reiserlab/LED-Display_G6_Hardware_Panel/panel_rp2354_20x20_four-color_v0p5/assets/panel_rp2354_20x20-v0.4.0-bottom.png

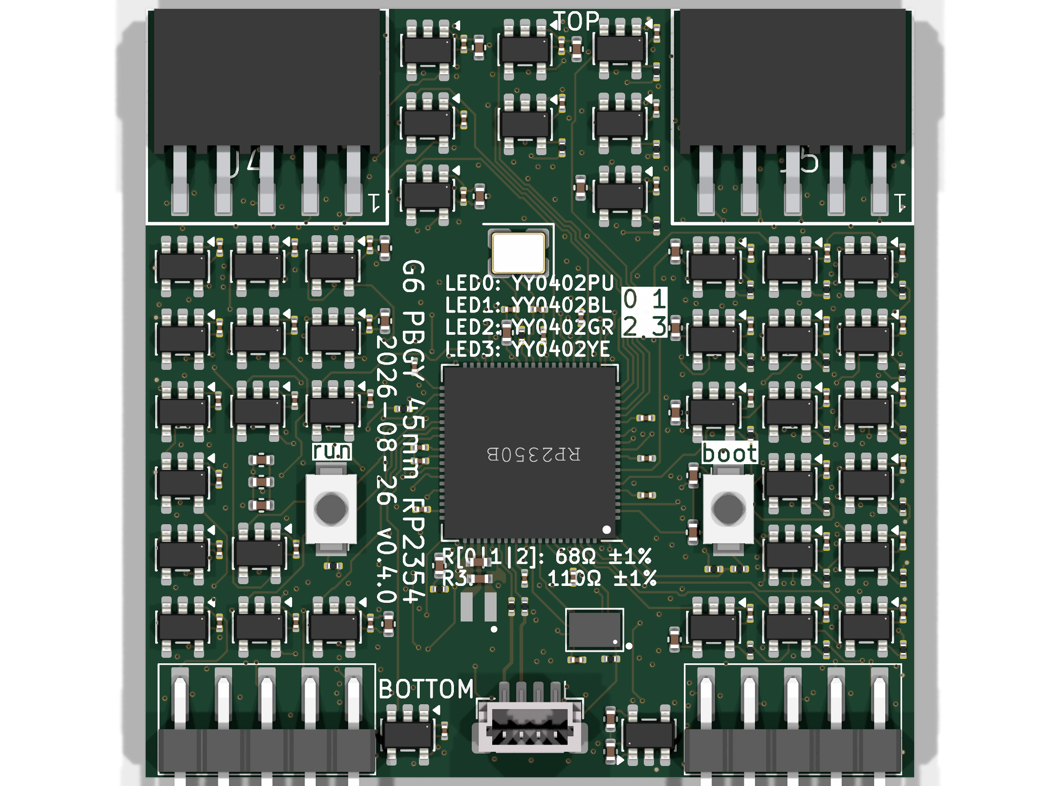
panel_rp2354_20x20_four-color_v0p5/assets/panel_rp2354_20x20-v0.4.0-bottom.png
