reiserlab/LED-Display_G6_Hardware_Panel/panel_rp2354_20x20_ir-red_v0p4/assets/panel_rp2354_20x20-v0.4.2-bottom-drivers-detail.png

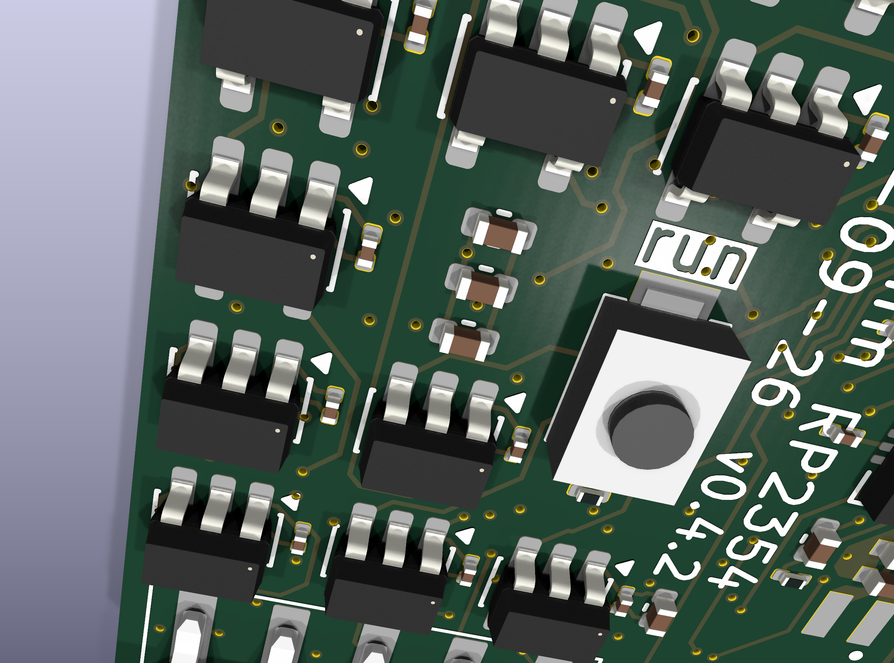
panel_rp2354_20x20_ir-red_v0p4/assets/panel_rp2354_20x20-v0.4.2-bottom-drivers-detail.png
