reiserlab/LED-Display_G6_Hardware_Panel/panel_rp2354_20x20_four-color_v0p5/production/v0p5r2/bom.csv

Designator | Footprint | Quantity | Value | LCSC Part #
C1, C2 | 0201 | 2 | 15pF | C541259
C10, C11, C12, C13, C14, C15, C16, C17, C18, C19, C20, C21, C22, C23, C24, C25, C26, C27, C28, C29, C3, C30, C31, C32, C33, C34, C35, C36, C37, C38, C39, C40, C41, C42, C43, C44, C45, C46, C47, C48, C49, C50, C51, C52, C53, C54, C55, C56, C57, C58, C6, C9 | 0201 | 52 | 100nF | C76939
C4, C5, C7, C8 | 0402 | 4 | 4.7uF | C368809
C59, C60, C61, C62, C63, C64, C65, C66, C67, C68, C69, C70, C71, C72, C73, C74, C75, C76 | 0402 | 18 | 10uF | C315248
D1, D10, D100, D11, D12, D13, D14, D15, D16, D161, D162, D163, D164, D165, D166, D167, D168, D169, D17, D170, D171, D172, D173, D174, D175, D176, D177, D178, D179, D18, D180, D19, D2, D20, D241, D242, D243, D244, D245, D246, D247, D248, D249, D250, D251, D252, D253, D254, D255, D256, D257, D258, D259, D260, D3, D321, D322, D323, D324, D325, D326, D327, D328, D329, D330, D331, D332, D333, D334, D335, D336, D337, D338, D339, D340, D4, D5, D6, D7, D8, D81, D82, D83, D84, D85, D86, D87, D88, D89, D9, D90, D91, D92, D93, D94, D95, D96, D97, D98, D99 | 0402 | 100 | LED_T0 | C43790508
D101, D102, D103, D104, D105, D106, D107, D108, D109, D110, D111, D112, D113, D114, D115, D116, D117, D118, D119, D120, D181, D182, D183, D184, D185, D186, D187, D188, D189, D190, D191, D192, D193, D194, D195, D196, D197, D198, D199, D200, D21, D22, D23, D24, D25, D26, D261, D262, D263, D264, D265, D266, D267, D268, D269, D27, D270, D271, D272, D273, D274, D275, D276, D277, D278, D279, D28, D280, D29, D30, D31, D32, D33, D34, D341, D342, D343, D344, D345, D346, D347, D348, D349, D35, D350, D351, D352, D353, D354, D355, D356, D357, D358, D359, D36, D360, D37, D38, D39, D40 | 0402 | 100 | LED_T1 | C44599418
D121, D122, D123, D124, D125, D126, D127, D128, D129, D130, D131, D132, D133, D134, D135, D136, D137, D138, D139, D140, D201, D202, D203, D204, D205, D206, D207, D208, D209, D210, D211, D212, D213, D214, D215, D216, D217, D218, D219, D220, D281, D282, D283, D284, D285, D286, D287, D288, D289, D290, D291, D292, D293, D294, D295, D296, D297, D298, D299, D300, D361, D362, D363, D364, D365, D366, D367, D368, D369, D370, D371, D372, D373, D374, D375, D376, D377, D378, D379, D380, D41, D42, D43, D44, D45, D46, D47, D48, D49, D50, D51, D52, D53, D54, D55, D56, D57, D58, D59, D60 | 0402 | 100 | LED_T2 | C9900325345
D141, D142, D143, D144, D145, D146, D147, D148, D149, D150, D151, D152, D153, D154, D155, D156, D157, D158, D159, D160, D221, D222, D223, D224, D225, D226, D227, D228, D229, D230, D231, D232, D233, D234, D235, D236, D237, D238, D239, D240, D301, D302, D303, D304, D305, D306, D307, D308, D309, D310, D311, D312, D313, D314, D315, D316, D317, D318, D319, D320, D381, D382, D383, D384, D385, D386, D387, D388, D389, D390, D391, D392, D393, D394, D395, D396, D397, D398, D399, D400, D61, D62, D63, D64, D65, D66, D67, D68, D69, D70, D71, D72, D73, D74, D75, D76, D77, D78, D79, D80 | 0402 | 100 | LED_T3 | C9900325346
J1 | JST_SH_BM04B-SRSS-TB_1x04-1MP_P1.00mm_Vertical | 1 | Conn_01x04 | C160390
J2, J3 | PinHeader_1x5_M20-8890545R | 2 | Conn_01x05 | C46061678
J4, J5 | ConnRcpt_1x5_SMH-105-02-X-S | 2 | Conn_01x05 | C5142238
J6 | JST_SH_BM03B-SRSS-TB_1x03-1MP_P1.00mm_Vertical | 1 | Conn_01x03 | C160389
L1 | L_pol_2016 | 1 | 3.3uH | C42411119
R1, R4 | 0201 | 2 | 10k | C473048
R10, R14, R18, R22, R26 | 0402 | 5 | R_T1 | C852891
R11, R15, R19, R23, R27 | 0402 | 5 | R_T2 | C852930
R12, R16, R20, R24, R28 | 0402 | 5 | R_T3 | C852485
R13, R17, R21, R25, R9 | 0402 | 5 | R_T0 | C852891
R2, R3, R5 | 0201 | 3 | 1k | C270365
R29, R6 | 0201 | 2 | 33 | C295794
R7, R8 | 0201 | 2 | 27 | C473051
SW1, SW2 | TS-1088-AR02016 | 2 | SW_Push | C720477
U1 | flashmem_PSON50P300X200X60-9N | 1 | APS6404L-3SQR | C3040877
U10, U11, U12, U13, U14, U15, U16, U17, U18, U19, U20, U21, U22, U23, U24, U25, U26, U27, U28, U29, U3, U30, U31, U32, U33, U34, U35, U36, U37, U38, U39, U4, U40, U41, U42, U5, U6, U7, U8, U9 | SOT-23-5 | 40 | UCC27517 | C99395
U2 | RP2350-QFN-80-1EP_10x10_P0.4mm_EP3.4x3.4mm_ThermalVias | 1 | RP2354B_80QFN | C39843328
U43 | SOT-23-5 | 1 | AP2112K-3.3 | C51118
Y1 | Crystal_SMD_3225-4Pin_3.2x2.5mm | 1 | ABM8-272-T3 | C20625731
