reiserlab/LED-Display_G6_Hardware_Panel/panel_rp2354_20x20_four-color_v0p5/assets/panel_rp2354_20x20-v0.4.0.step

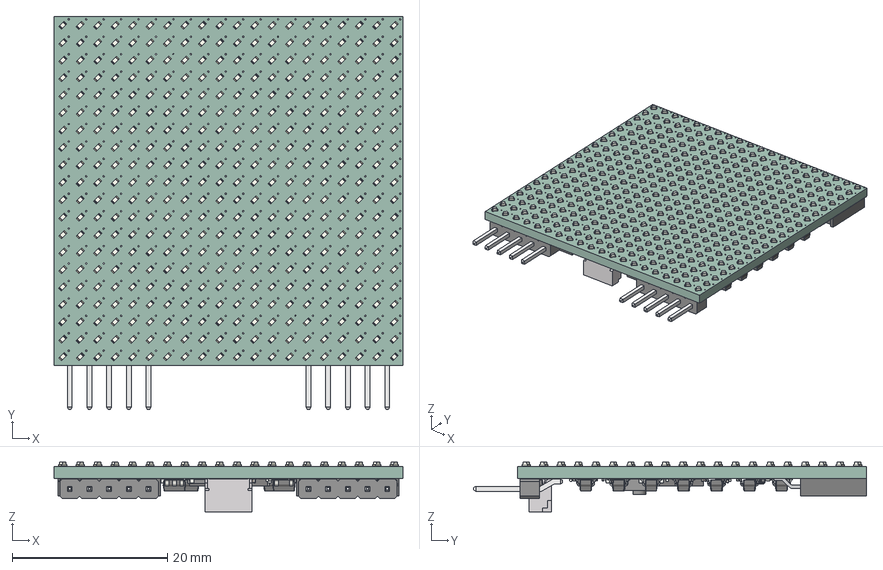
[picture p12: CAD file, 2026-10-18, an earlier design]
panel_rp2354_20x20_four-color_v0p5/assets/panel_rp2354_20x20-v0.4.0.step
45.0 x 50.7 x 6.43 mm
LED_0402_1005Metric x 400
C_0201_0603Metric x 54
C_0402_1005Metric x 22
SOT-23-5 x 41
R_0201_0603Metric x 29
BM04B-SRSS
Crystal_SMD_3225-4Pin_3.2x2.5mm
insulation_001 x 2
pin_001 x 2
pin_002 x 2
pin_003 x 2
pin_004 x 2
pin_005 x 2
ButtonPad x 2
rp2350text
panel_rp2354_20x20_silkscreen x 2
panel_rp2354_20x20_PCB
