reiserlab/LED-Display_G6_Hardware_Panel/(list of files, cad)

Other CAD files:
panel_rp2354_20x20_four-color_v0p5/assets/panel_rp2354_20x20-v0.5.0.step
