reiserlab/LED-Display_G6_Hardware_Panel/panel_rp2354_20x20_four-color_v0p5/assets/panel_rp2354_20x20-v0.5.0.pdf

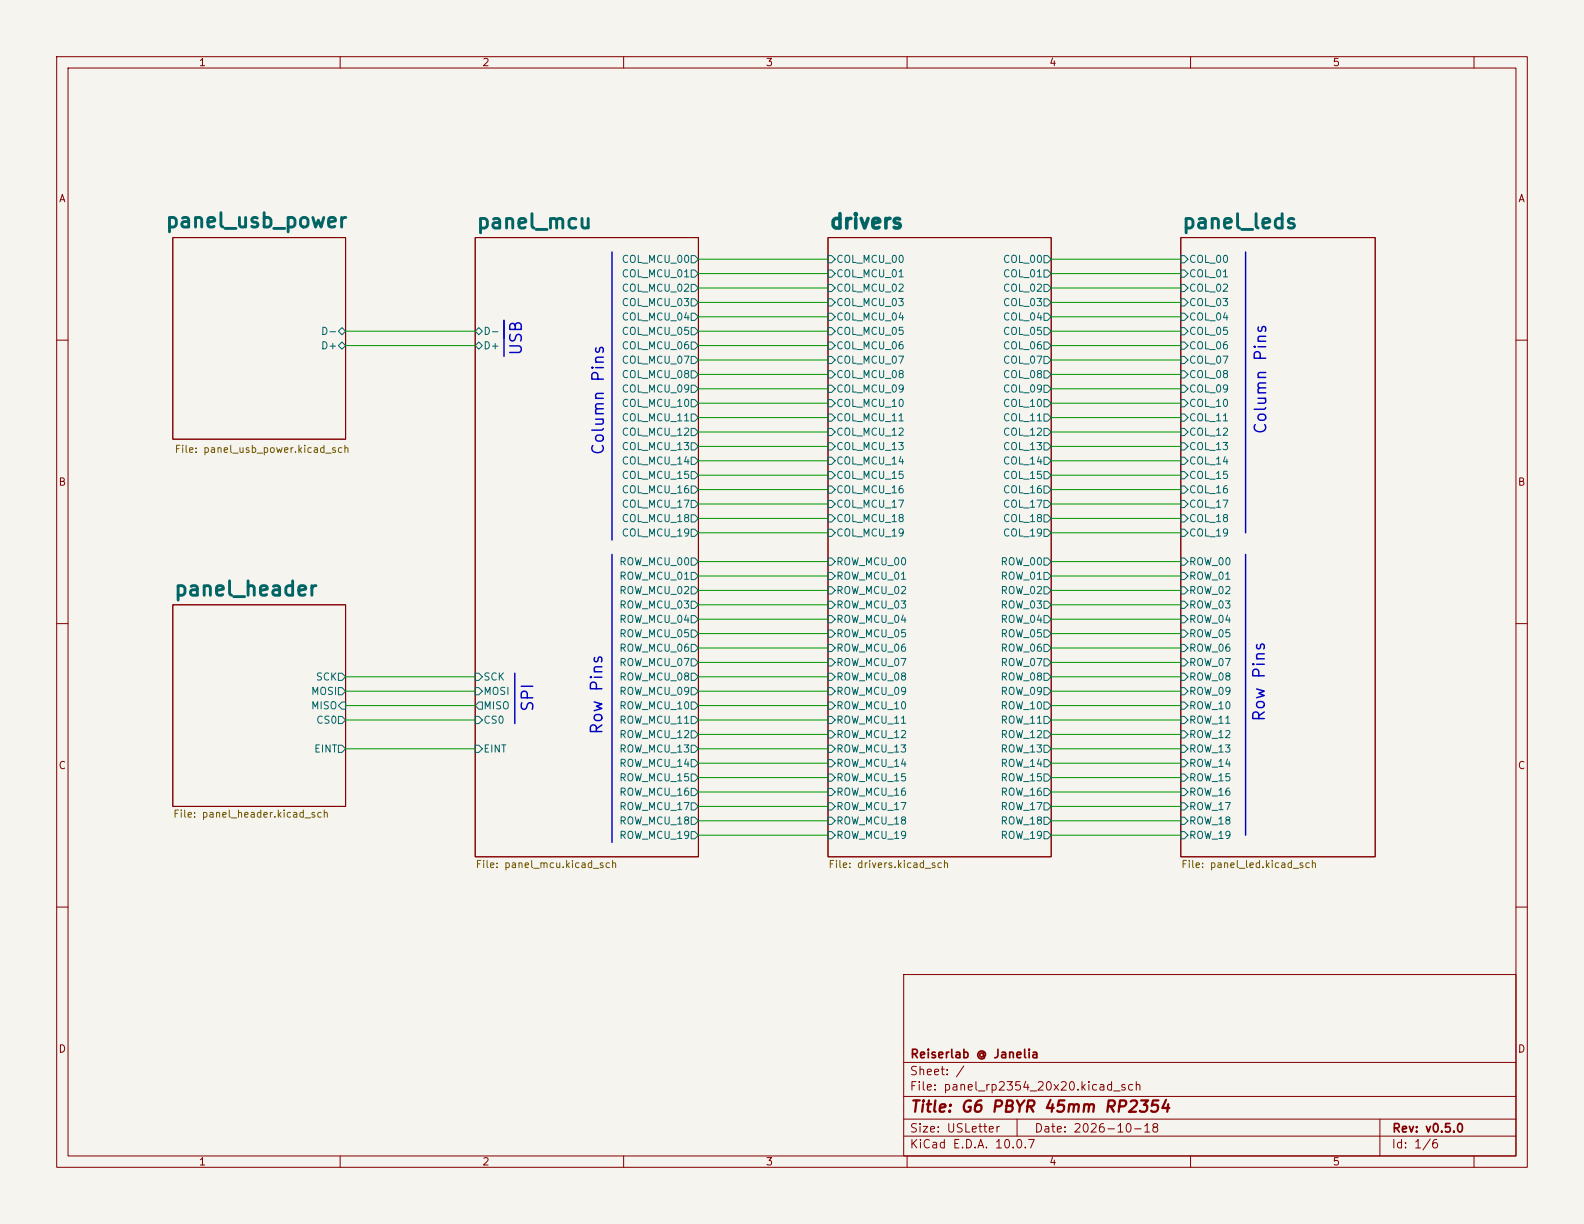
[picture p19: page 1]

Size: USLetter | Rev: v0.5.0
KiCad E.D.A. 10.0.7 | Id: 1/6

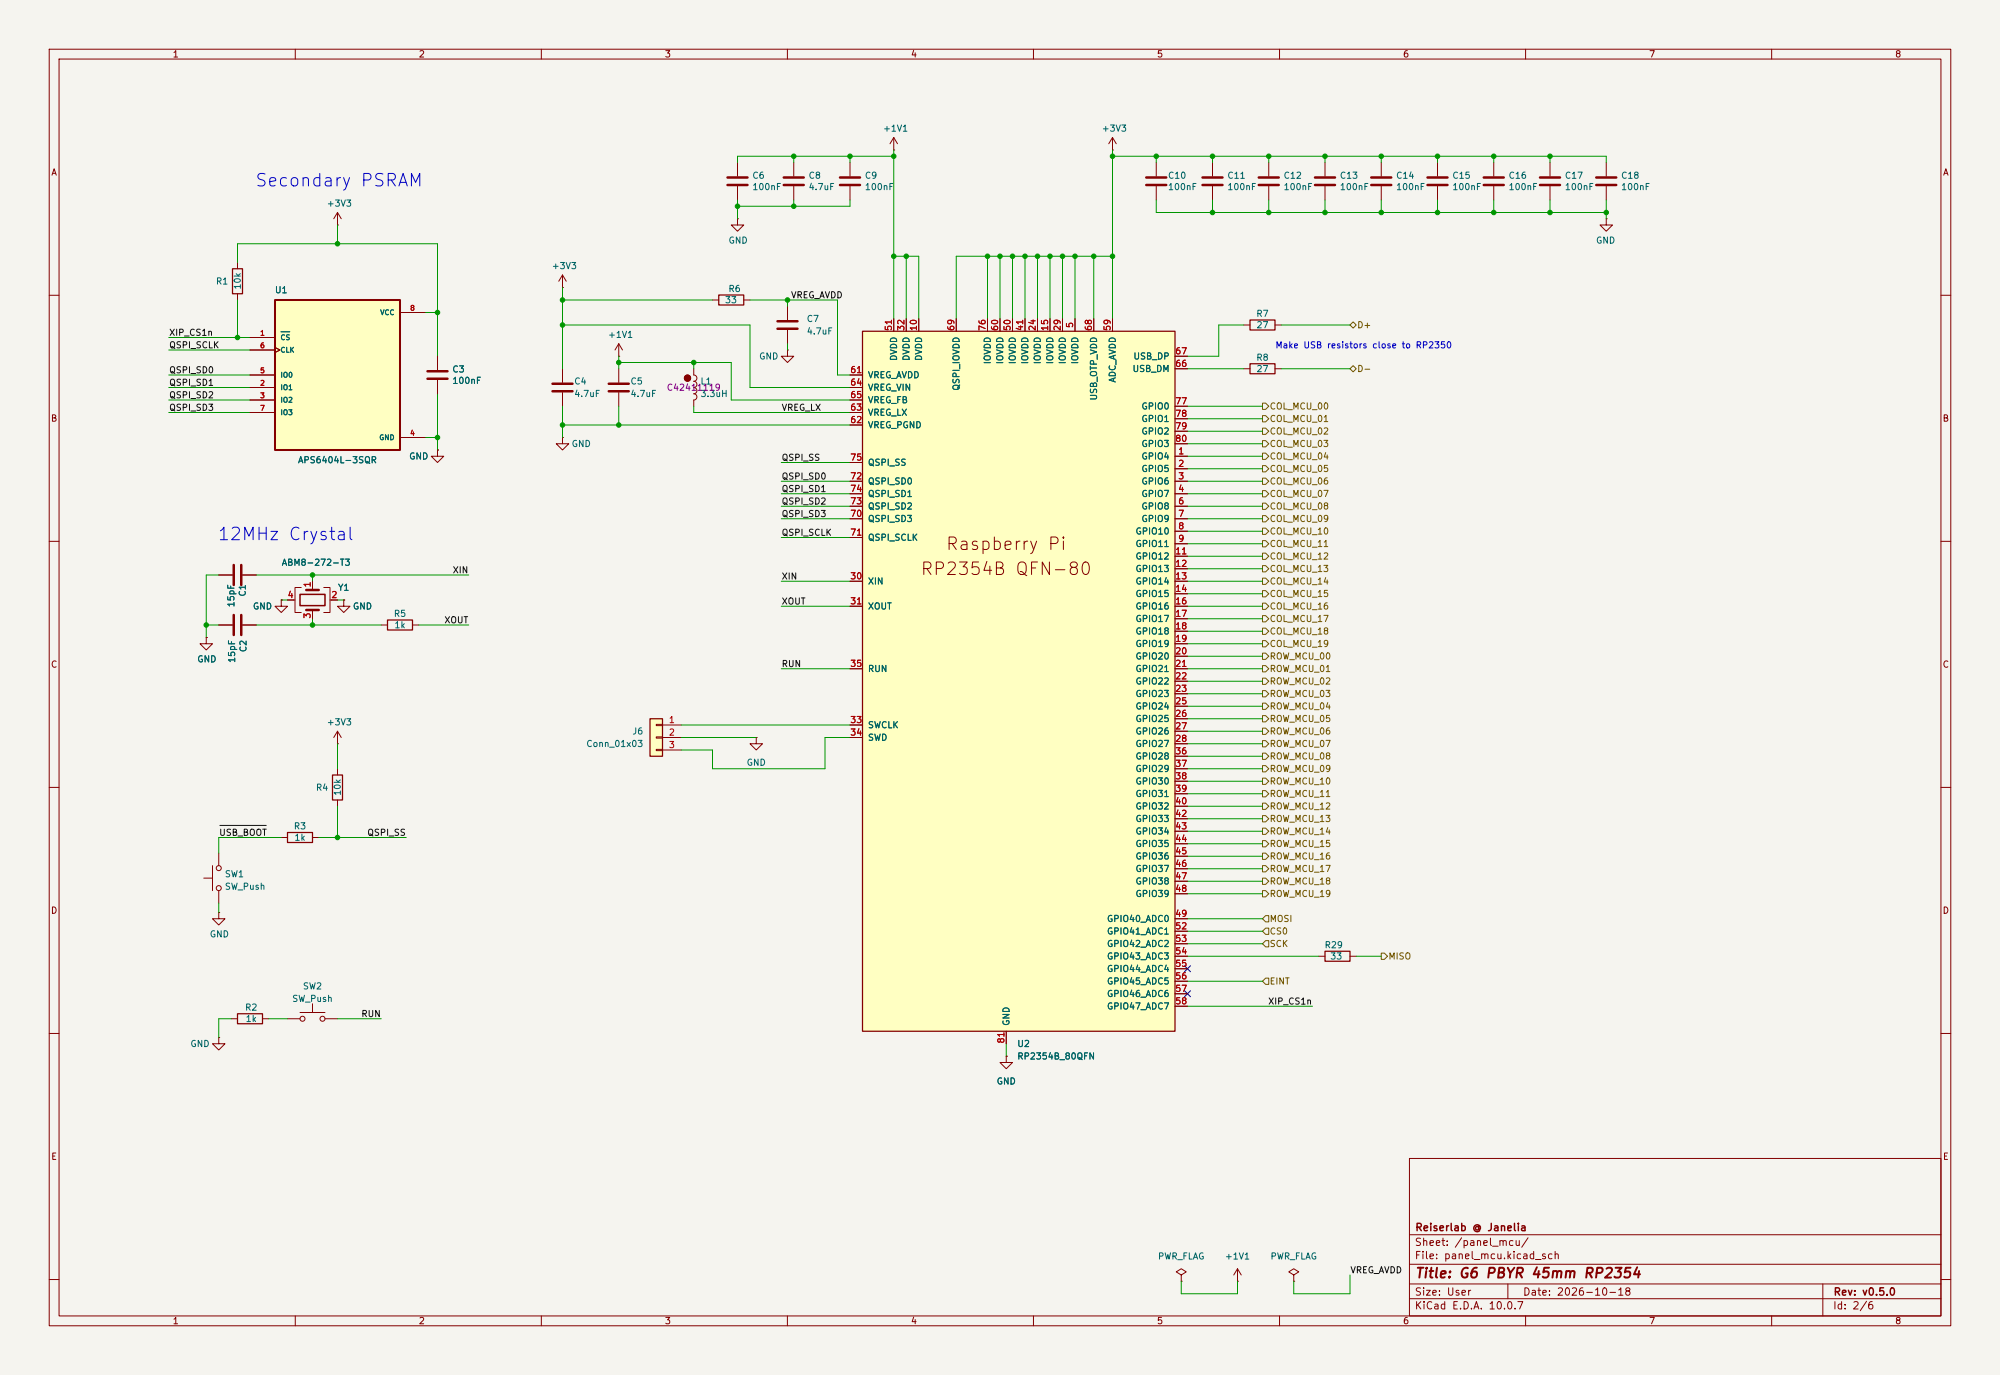
[picture p20: page 2]

5 GPIO8 6 GPIO9 7 GPIO10 8 GPIO11 9 DVDD 10 GPIO12 11 GPIO13 12 GPIO14 13 GPIO15 14 IOVDD 15 GPIO16 16 GPIO17 17 GPIO18 18 GPIO19 19 GPIO20 20 GPIO21 21 GPIO22 22 GPIO23 23 IOVDD 24 GPIO24 25 GPIO25 26 GPIO26 27 GPIO27 28 IOVDD 29

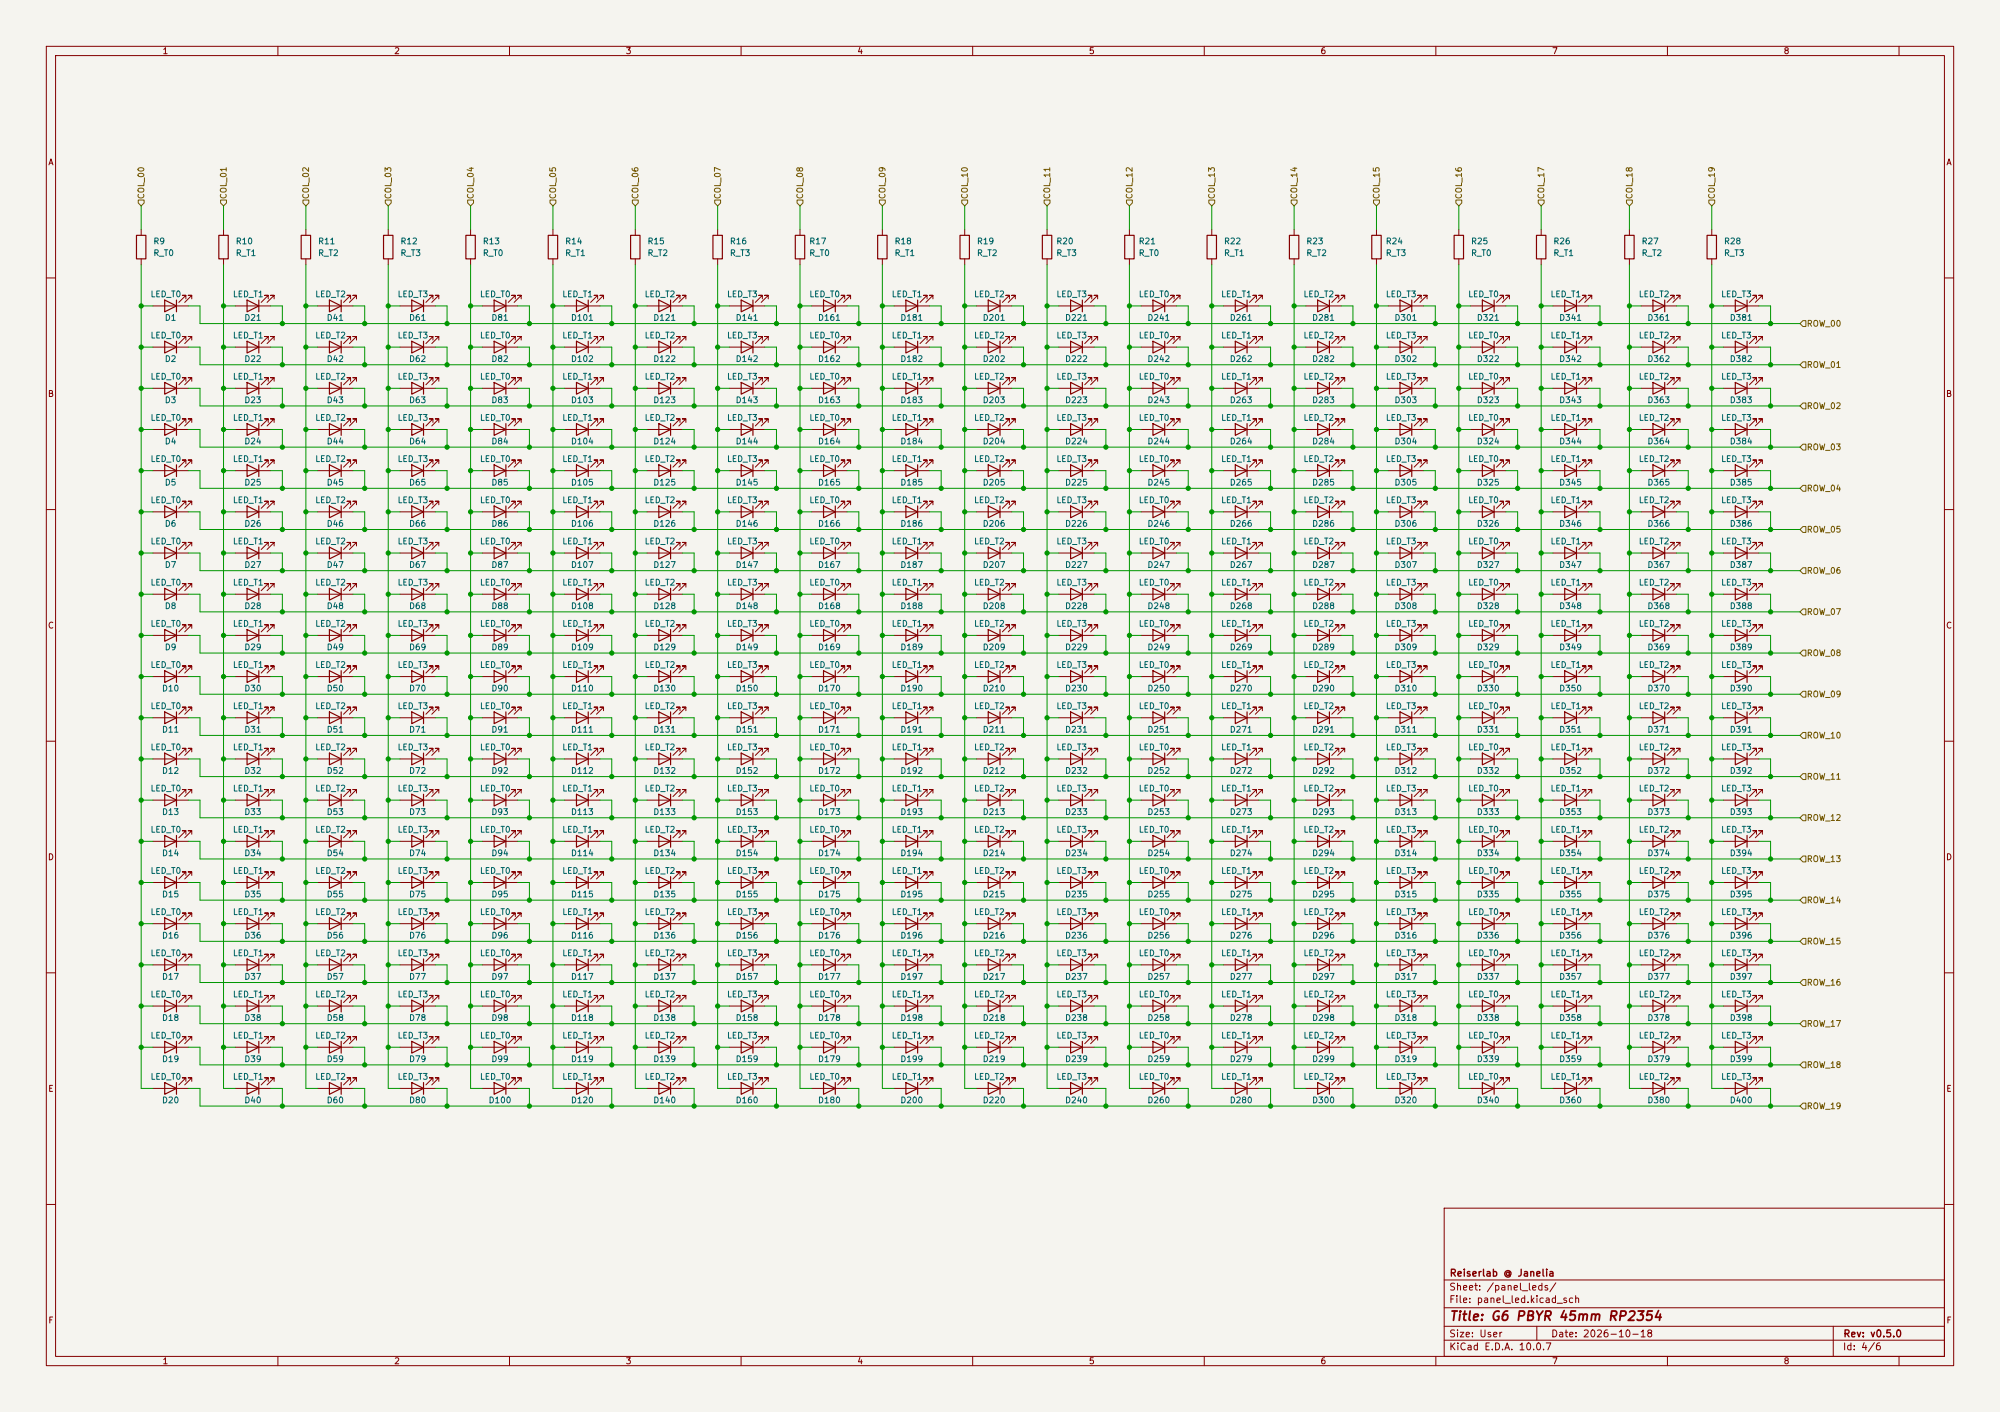
[picture p21: page 3]

LED_T0 D2 LED_T0 | | | LED_T3 | | R14 R_T1 | D122 LED_T2 | LED_T3 R15 R_T2 D64 D143 LED_T3 | | LED_T1 | LED_T2 D162 | | LED_T0 | D262 | LED_T2 D282

LED_T0 | | LED_T2 | LED_T3 | LED_T0 D83 | | | | | | D204 | LED_T3 D63 | | | | LED_T1 D270

LED_T2 | | LED_T0 | LED_T1 | | | | D186 D183 | LED_T2 D202 | D223 | LED_T0 D243 | LED_T1 D265 | | | LED_T0 D322 | LED_T1 | LED_T2 D323 D363

LED_T0 | LED_T1 | | | | | LED_T2 D124 | | | LED_T1 D188 | D203 | | | | | LED_T3 D305 LED_T3 | | LED_T1 D345 | LED_T2 D365
LED_T1 LED_T1 D28 | LED_T2 | D75 | LED_T0 D88 | LED_T1 | LED_T2 D48 D128 | | | | LED_T2 D208 | D234 | | | | LED_T3 | | D348 | LED_T3 D347

LED_T2 D45 | LED_T3 LED_T3 D66 | | D104 | | | | LED_T1 D189 | | | | | | LED_T1 D272

LED_T2 | | | LED_T1 D107 | LED_T2 D127 D126 | | LED_T0 D165 | | LED_T2 D170 | LED_T3 D185 LED_T3 D226 | LED_T0 LED_T0 D247 | LED_T1 | | | | D343 | D370

LED_T0 D9 | LED_T1 D29 | | | | LED_T1 | LED_T2 D129 | D148 | | LED_T1 D36 | | | LED_T0 LED_T0 D249 | LED_T1 D269 | D285 LED_T2 D289 | | | LED_T1 D312 | LED_T2 D369

LED_T0 | D110 | | LED_T3 D74 | | LED_T1 | LED_T2 D210 | D232 | | | | LED_T3 | | D346

LED_T0 | | LED_T2 D51 | LED_T3 D71 | | LED_T1 D112 | LED_T2 D132 | LED_T3 D119 | LED_T0 D172 | | LED_T2 D212 | | LED_T0 D258 LED_T0 D252 | LED_T1 D278 LED_T1 | LED_T2 | D310 | LED_T0 D332 | D360 LED_T1 D318
LED_T0 D10 | | LED_T2 D50 | LED_T3 | | LED_T1 D109 LED_T1 D111 | D137 LED_T2 D131 | LED_T3 D151 | | | | | LED_T0 | D267 LED_T1 | LED_T2 | D307 | | | LED_T2

LED_T1 D33 | LED_T2 LED_T2 D52 | LED_T3 | | | | | LED_T0 D97 LED_T0 D55 | D190 | LED_T2 D215 | D229 | | LED_T1 D230 | | LED_T3 D313 | LED_T0 D339 | LED_T1 D309 | LED_T2 D372

LED_T0 LED_T0 LED_T0 D14 | LED_T1 D34 | | LED_T3 | | | | | LED_T0 D177 LED_T0 D174 | LED_T1 D194 | D219 | D231 LED_T3 | | | LED_T2 | D315 D314 | LED_T0 | LED_T1 D355 | LED_T3 D158 LED_T3 D113 LED_T2

LED_T3 D73 | LED_T0 | LED_T1 D114 | LED_T2 D136 LED_T2 D133 | D157 LED_T3 D154 LED_T3 | D173 | LED_T1 D193 | | | LED_T0 D254 | LED_T1 D274 | | | LED_T0 D333 | | LED_T2 D373

LED_T0 | LED_T1 | LED_T2 | LED_T3 | | LED_T1 D115 | LED_T2 | | | D199 LED_T1 | LED_T2 D13 | D235 | LED_T0 D256 | LED_T1 D275

LED_T0 | LED_T1 | | LED_T3 | LED_T0 | | | LED_T3 D116 | LED_T0 D176 | | LED_T2 D216 | LED_T3 D236 | LED_T0 | | | LED_T3 D317 | LED_T0 | D356
LED_T0 | LED_T1 | LED_T2 | | LED_T0 | LED_T1 D118 | | | LED_T0 | LED_T1 D198 LED_T1 | | | | | | | | | LED_T2 D378 D377

LED_T0 | LED_T1 | LED_T2 | LED_T3 | | | LED_T2 D138 | | | | LED_T2 | LED_T3 D239 | LED_T0 D259 LED_T0 | | | LED_T3 D319 | LED_T0 | D358

LED_T1 | LED_T2 | LED_T3 | LED_T0 | LED_T1 | | LED_T3 D160 | LED_T0 | | | LED_T3 D240 | LED_T0 | LED_T1 | LED_T2 | LED_T3 | | LED_T1 | LED_T2 D380 LED_T2

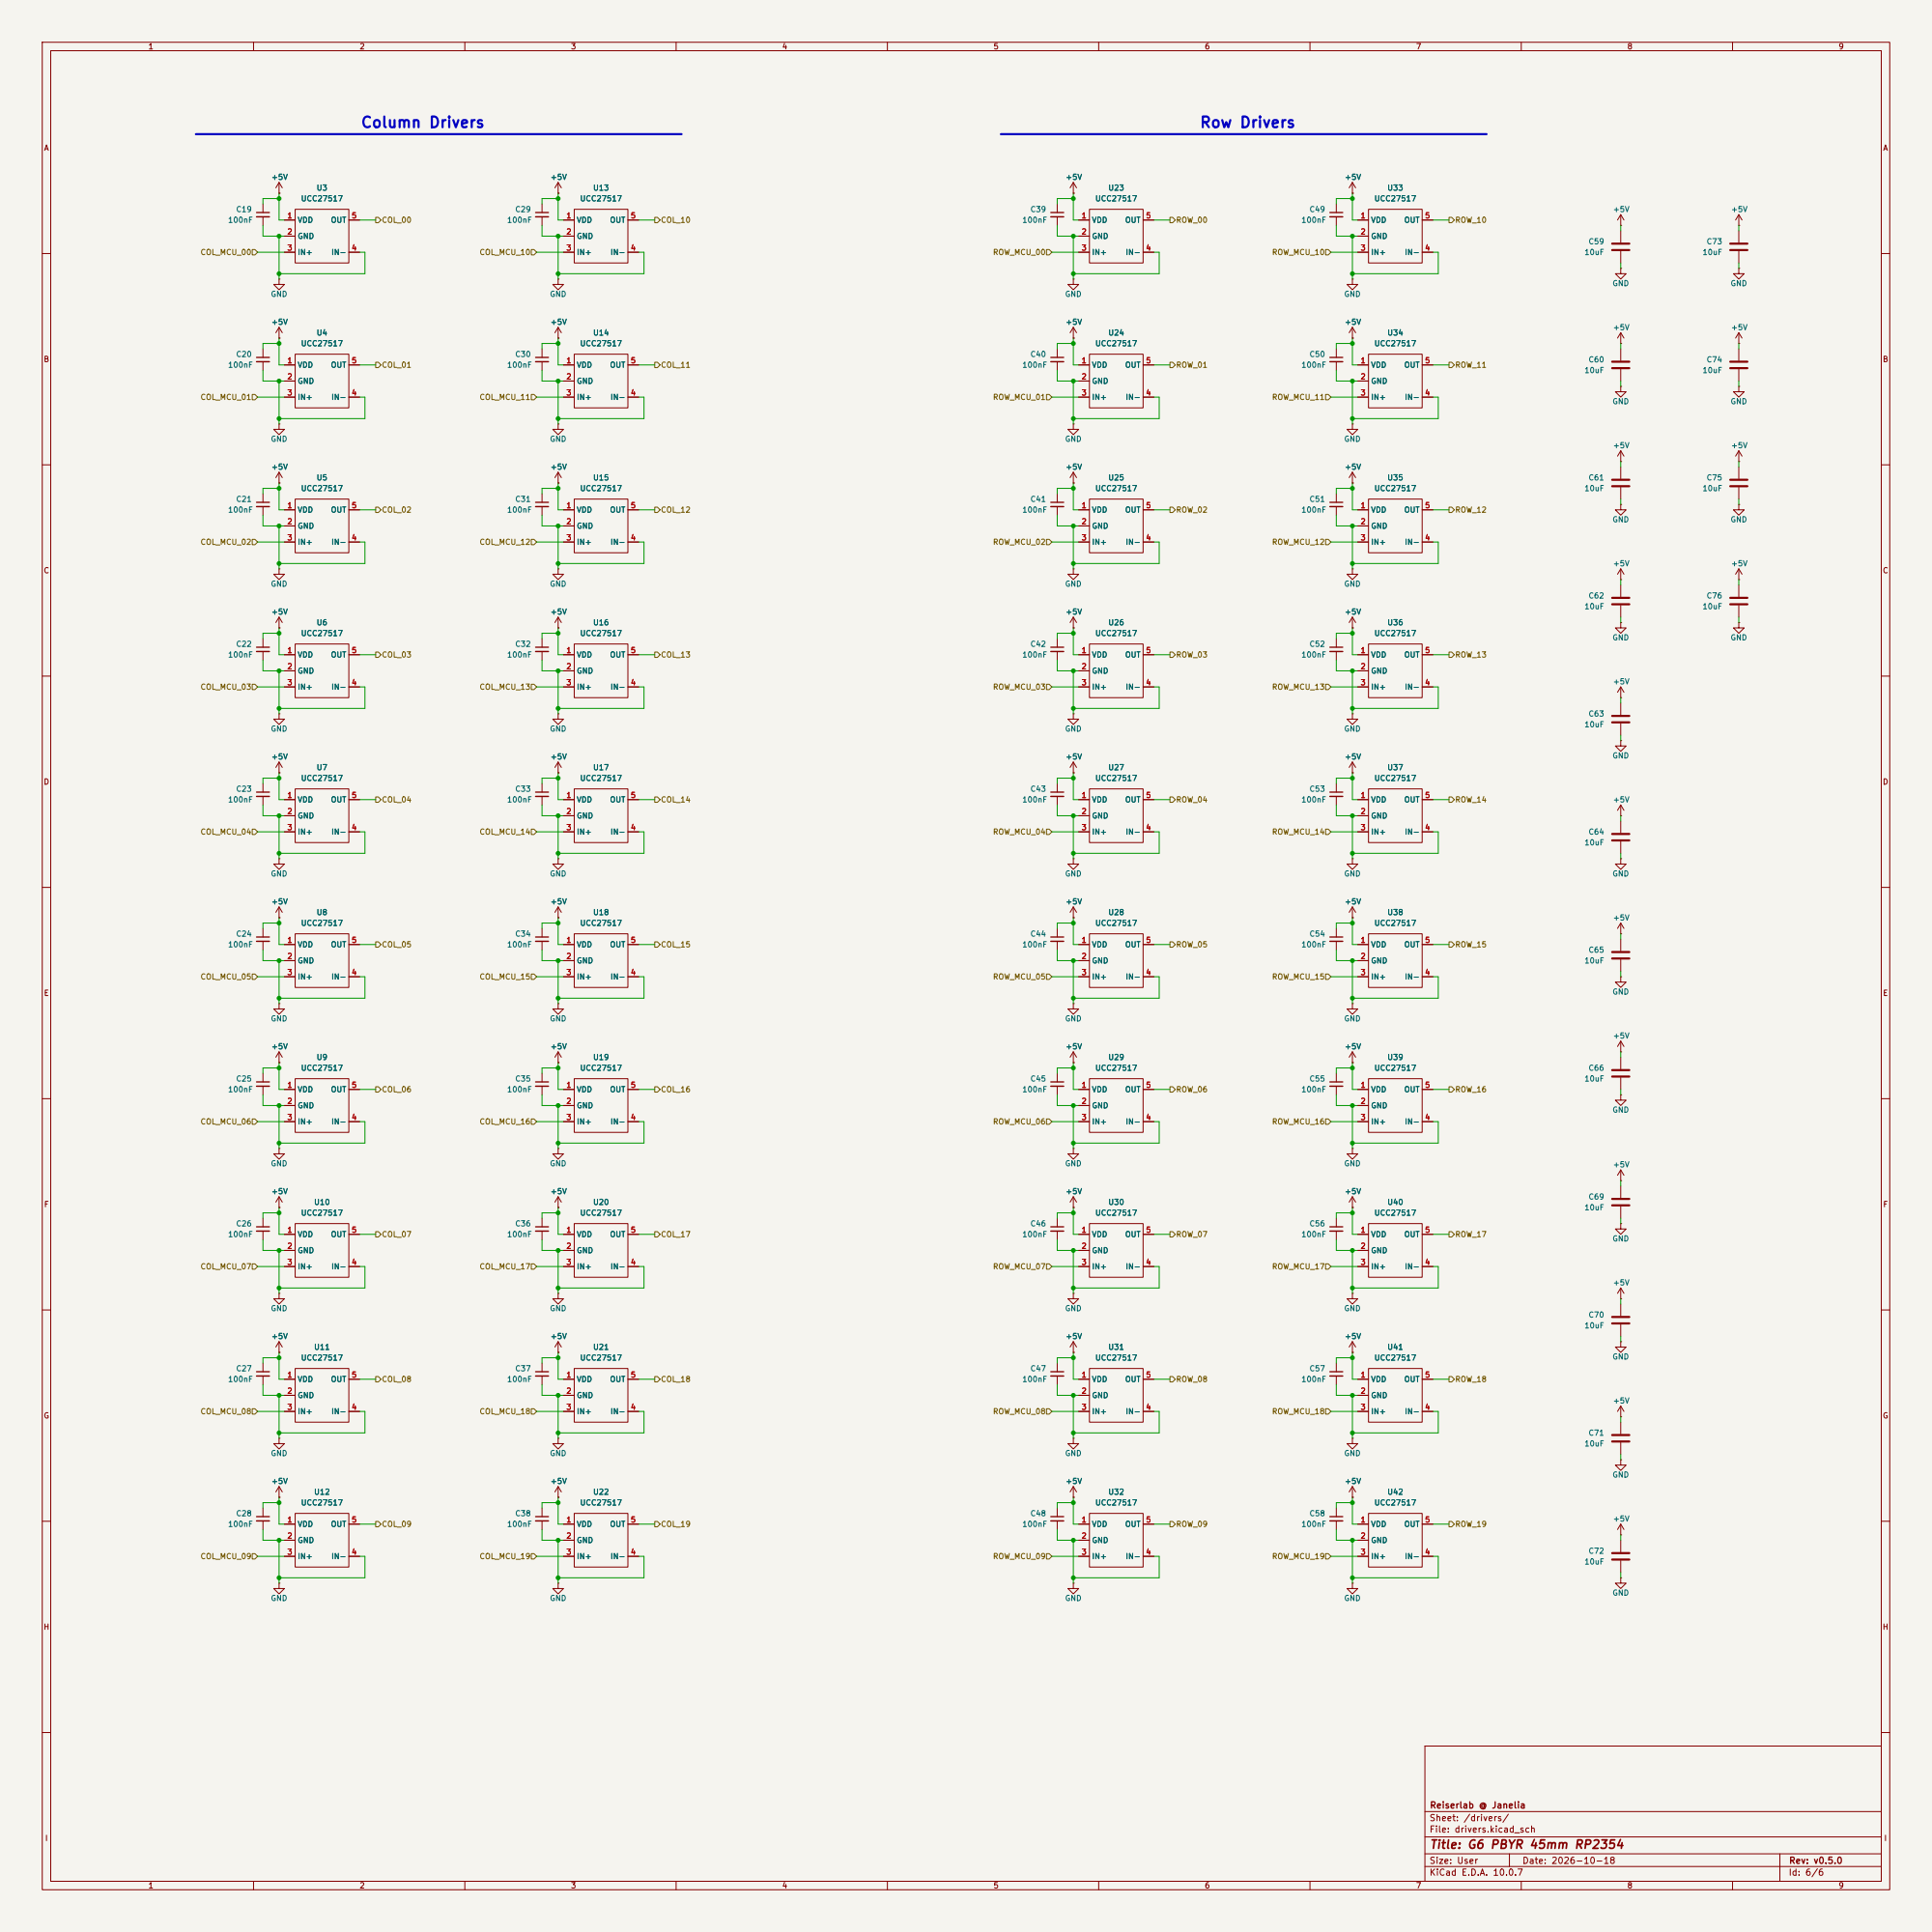
[picture p22: page 4]

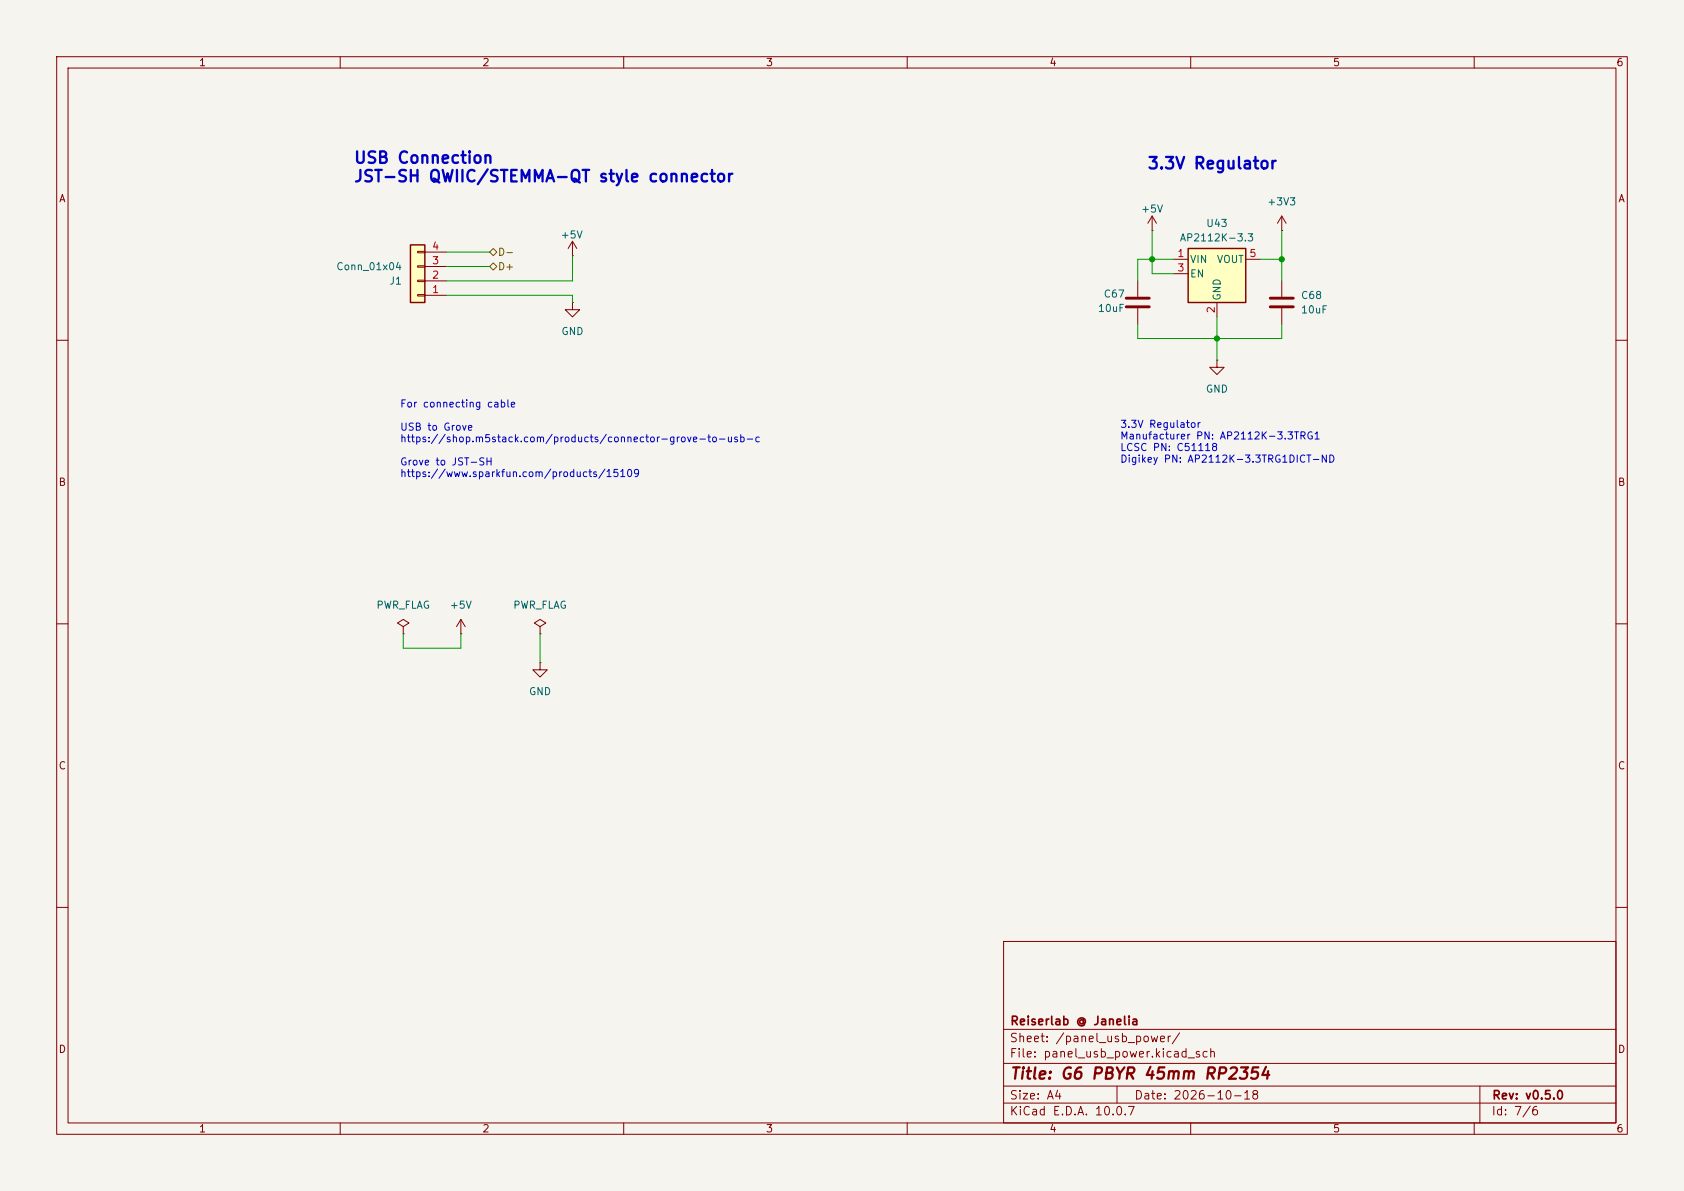
[picture p23: page 5]

LCSC PN: C51118 Digikey PN: AP2112K-3.3TRG1DICT-ND For connecting cable USB to Grove https://shop.m5stack.com/products/connector-grove-to-usb-c Grove to JST-SH https://www.sparkfun.com/products/15109

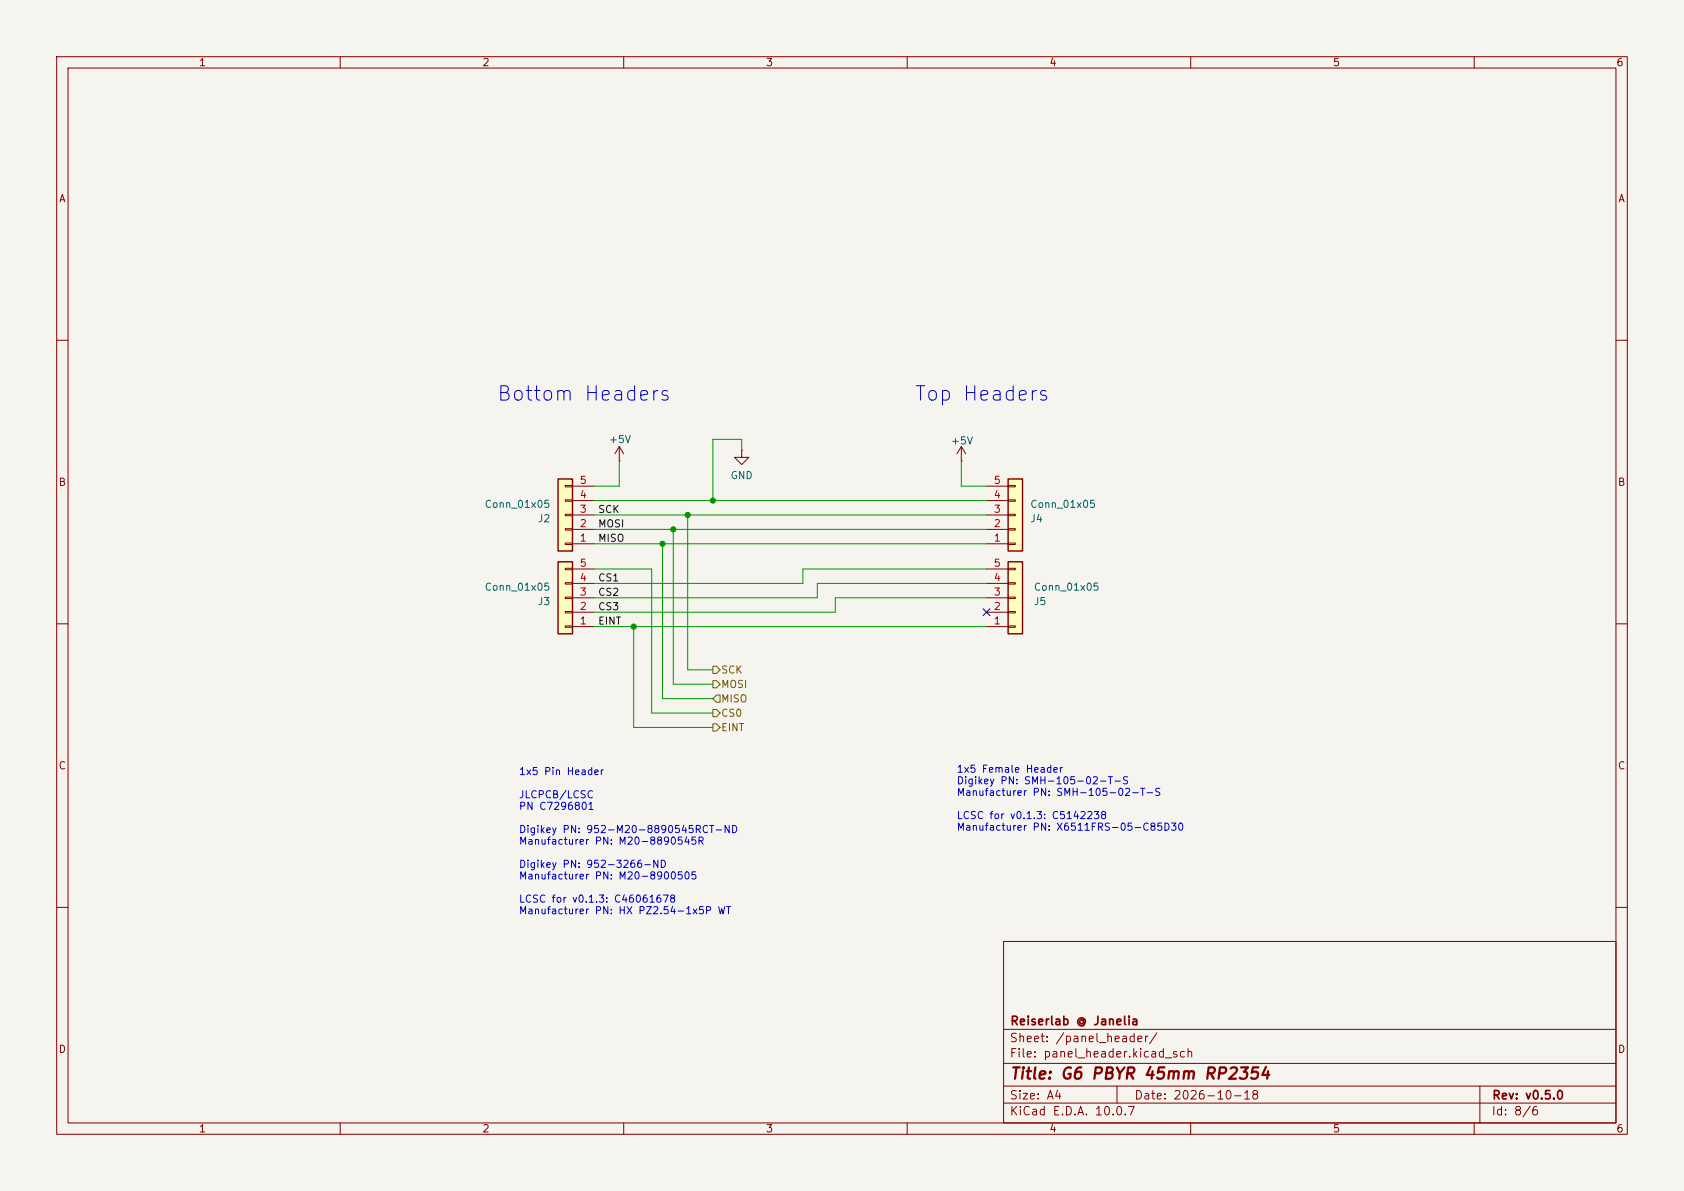
[picture p24: page 6]

SCK MOSI MISO 2 | 2

1x5 Pin Header JLCPCB/LCSC

PN C7296801 Digikey PN: 952-M20-8890545RCT-ND Manufacturer PN: M20-8890545R

Digikey PN: 952-3266-ND Manufacturer PN: M20-8900505

LCSC for v0.1.3: C46061678 Manufacturer PN: HX PZ2.54-1x5P WT
