reiserlab/LED-Display_G6_Hardware_Panel/panel_rp2354_20x20_four-color_v0p5/panel_rp2354_20x20.kicad_pcb

## KiCad design panel_rp2354_20x20_four-color_v0p5/panel_rp2354_20x20.kicad_pcb (2026-11-02)

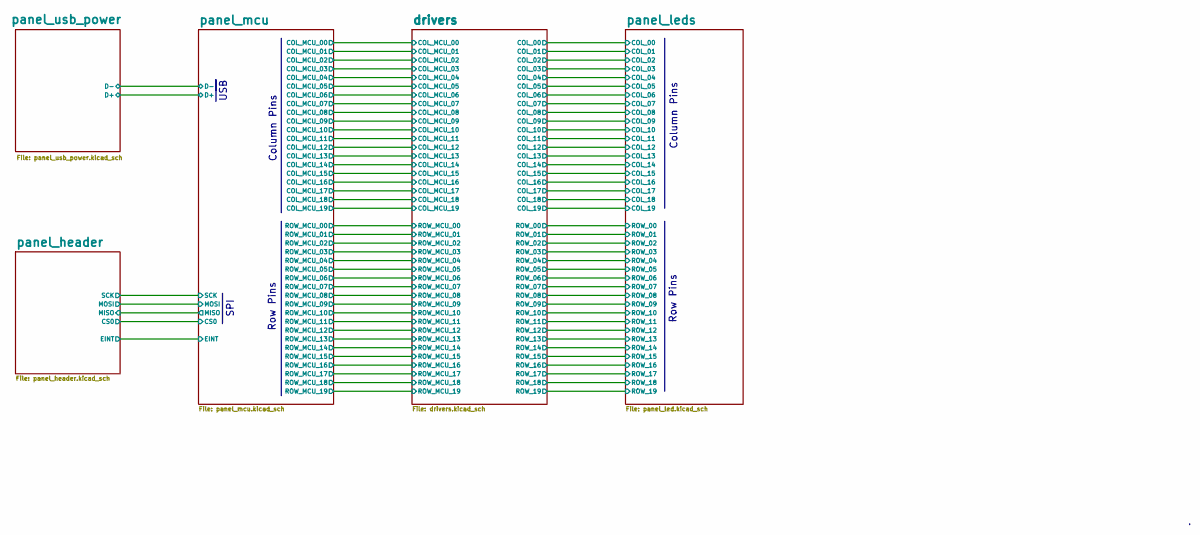
[picture p31: schematic panel_rp2354_20x20.kicad_sch, G6 PBYR 45mm RP2354]

Notes on the sheet:
Column Pins
Row Pins
SPI
USB

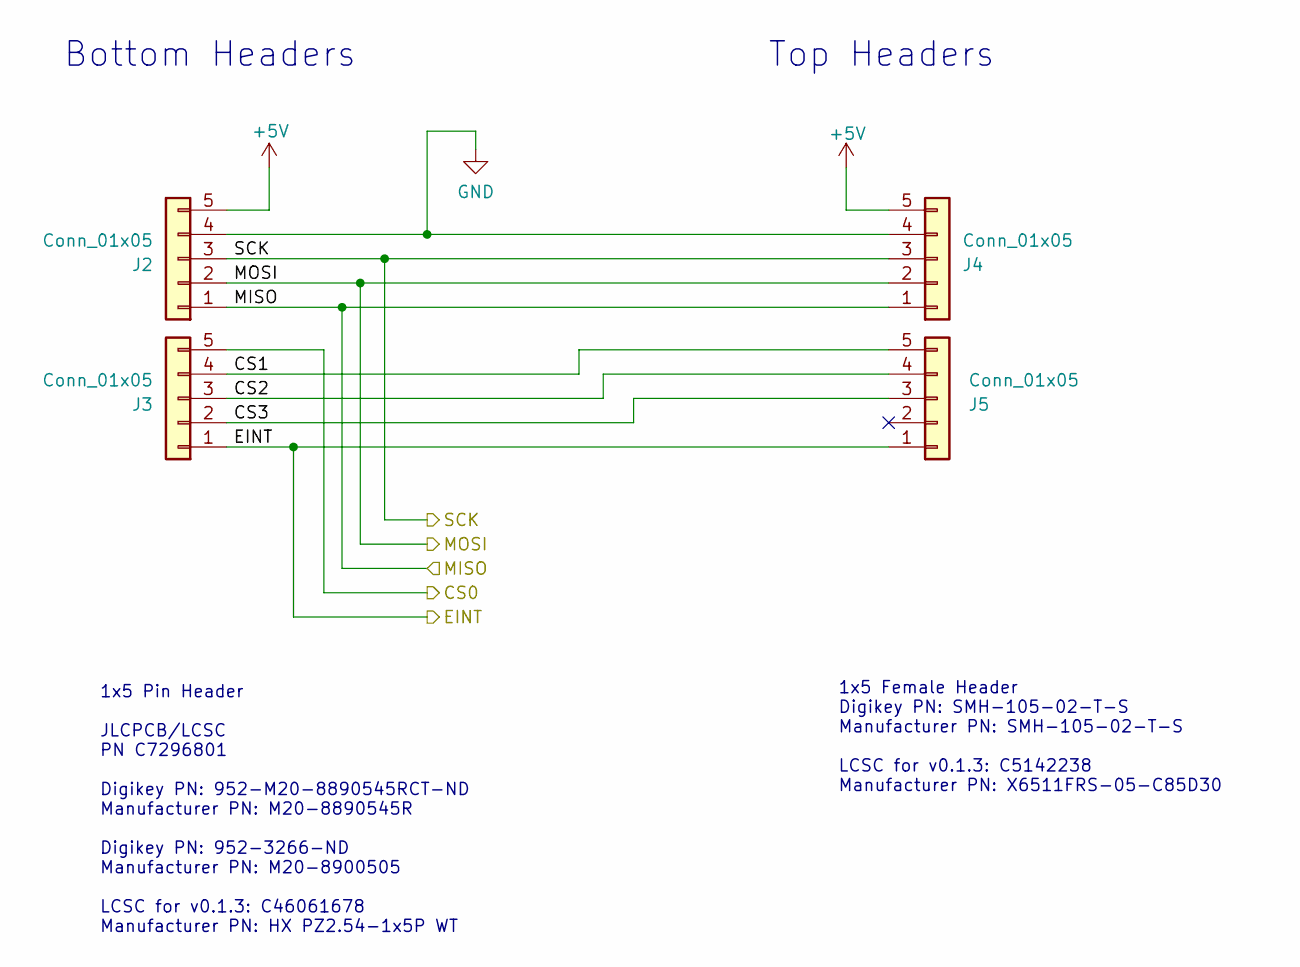
[picture p32: schematic panel_header.kicad_sch, G6 PBYR 45mm RP2354]

Parts:
J2, J3: Conn_01x05; PinHeader_1x5_M20-8890545R; LCSC Part # C46061678
J4, J5: Conn_01x05; ConnRcpt_1x5_SMH-105-02-X-S; LCSC Part # C5142238

Connections:
+5V: J2.5, J4.5; also elsewhere on the board
/panel_header/CS0: J3.5; also elsewhere on the board
/panel_header/CS1: J3.4, J5.5
/panel_header/CS2: J3.3, J5.4
/panel_header/CS3: J3.2, J5.3
/panel_header/EINT: J3.1, J5.1; also elsewhere on the board
/panel_header/MISO: J2.1, J4.1; also elsewhere on the board
/panel_header/MOSI: J2.2, J4.2; also elsewhere on the board
/panel_header/SCK: J2.3, J4.3; also elsewhere on the board
GND: J2.4, J4.4; also elsewhere on the board

Notes on the sheet:
1x5 Pin Header JLCPCB/LCSC PN C7296801 Digikey PN: 952-M20-8890545RCT-ND Manufacturer PN: M20-8890545R Digikey PN: 952-3266-ND Manufacturer PN: M20-8900505 LCSC for v0.1.3: C46061678 Manufacturer PN: HX PZ2.54-1x5P WT
Top Headers
1x5 Female Header Digikey PN: SMH-105-02-T-S Manufacturer PN: SMH-105-02-T-S LCSC for v0.1.3: C5142238 Manufacturer PN: X6511FRS-05-C85D30
Bottom Headers

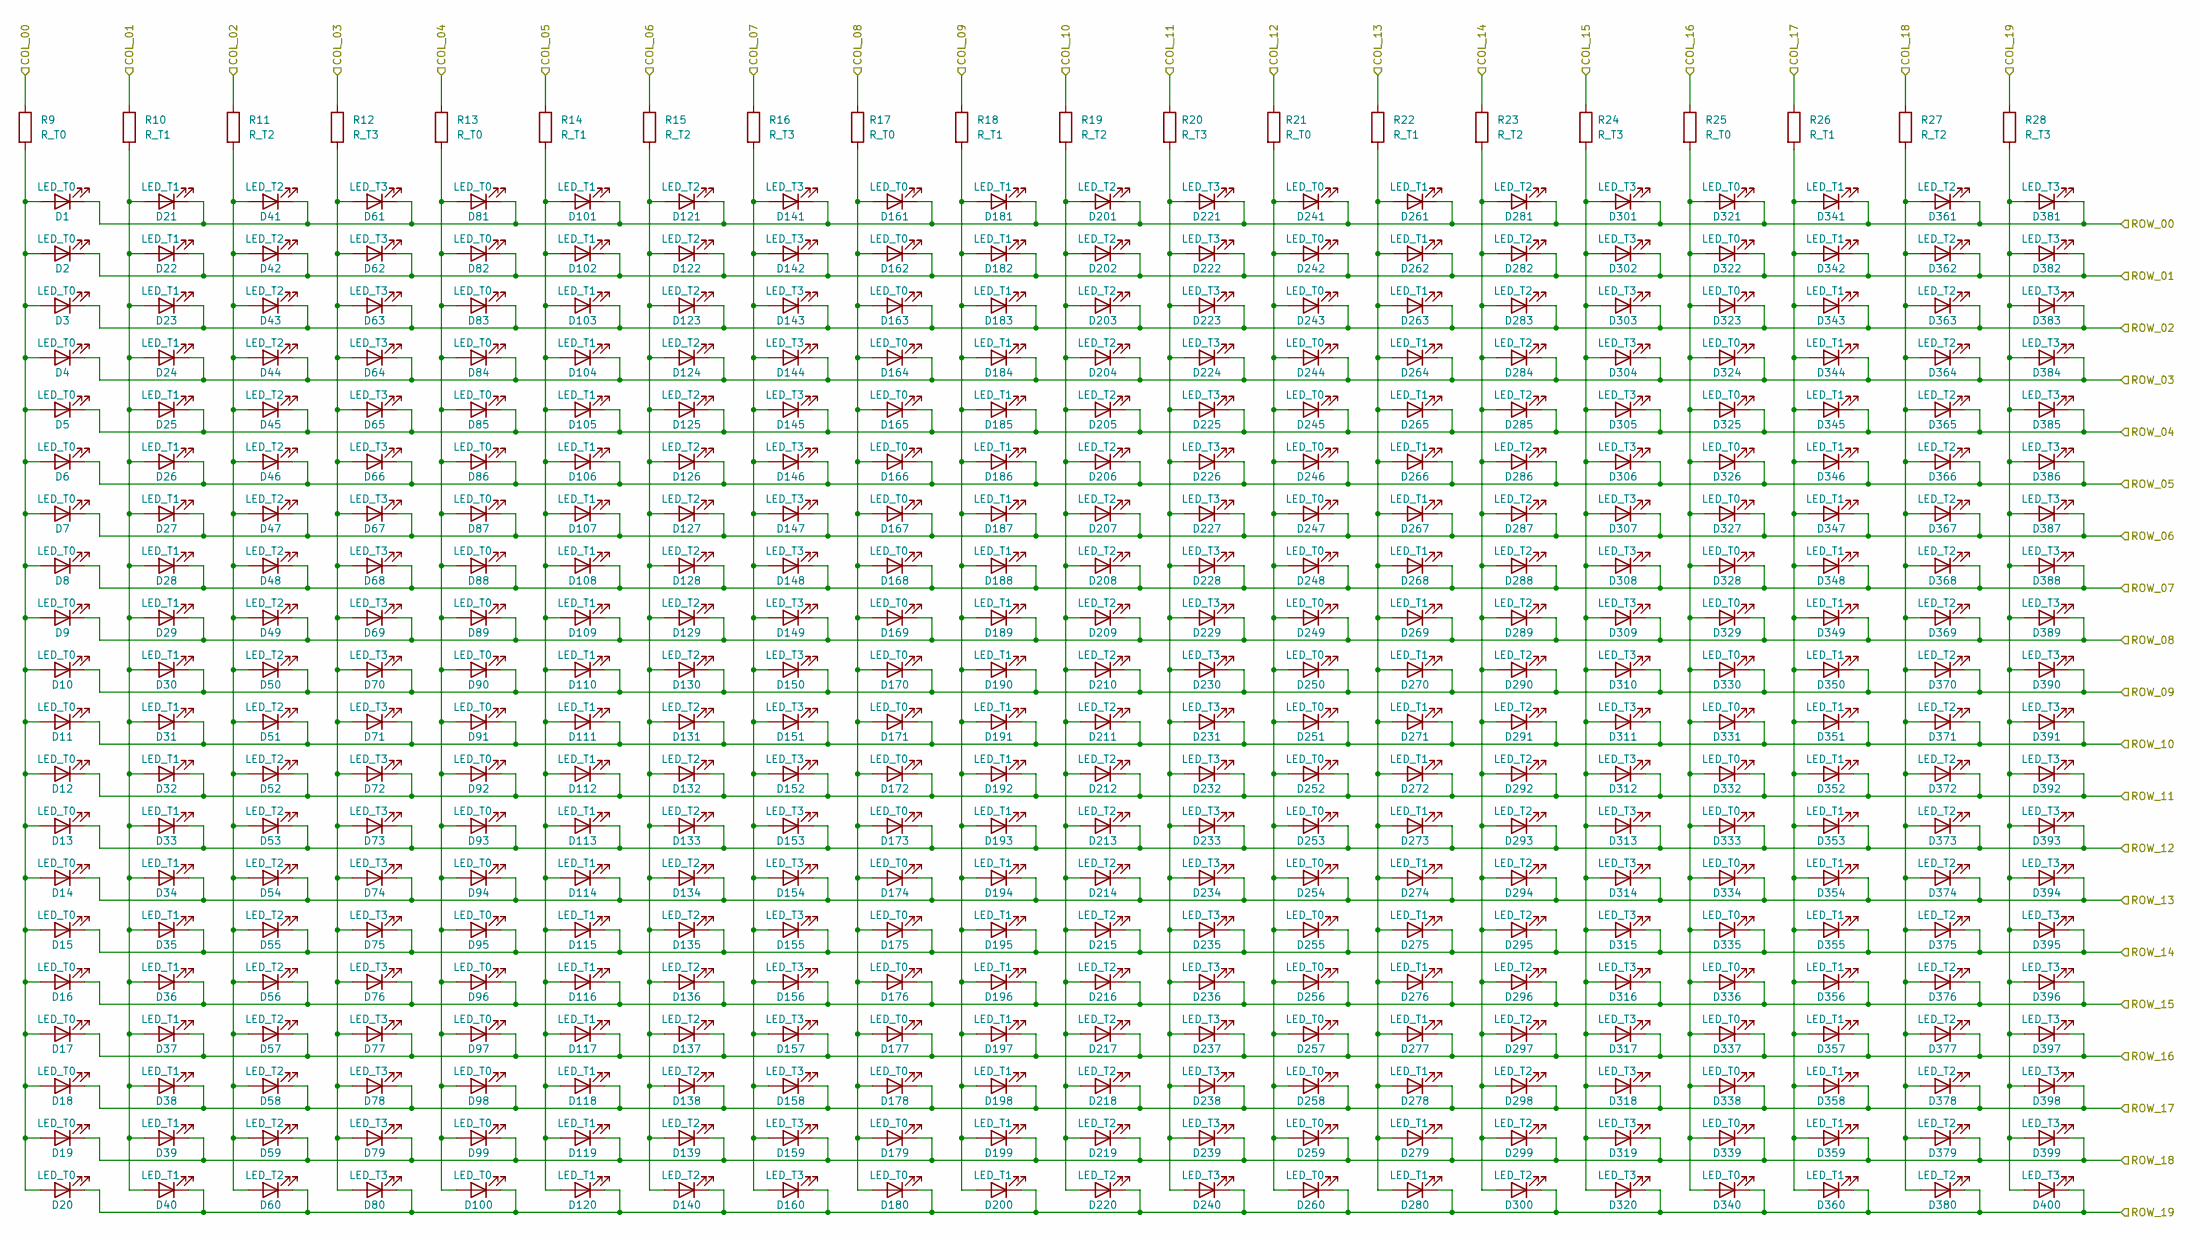
[picture p33: schematic panel_led.kicad_sch, G6 PBYR 45mm RP2354]

Parts:
D1, D2, D3, D4, D5, D6, D7, D8, D9, D10, D11, D12, D13, D14, D15, D16, D17, D18, D19, D20, D81, D82, D83, D84, D85, D86, D87, D88, D89, D90, D91, D92, D93, D94, D95, D96, D97, D98, D99, D100, D161, D162, D163, D164, D165, D166, D167, D168, D169, D170, D171, D172, D173, D174, D175, D176, D177, D178, D179, D180, D241, D242, D243, D244, D245, D246, D247, D248, D249, D250, D251, D252, D253, D254, D255, D256, D257, D258, D259, D260, D321, D322, D323, D324, D325, D326, D327, D328, D329, D330, D331, D332, D333, D334, D335, D336, D337, D338, D339, D340: LED_T0; LED_0402_1005Metric; LCSC Part # C43790508
D21, D22, D23, D24, D25, D26, D27, D28, D29, D30, D31, D32, D33, D34, D35, D36, D37, D38, D39, D40, D101, D102, D103, D104, D105, D106, D107, D108, D109, D110, D111, D112, D113, D114, D115, D116, D117, D118, D119, D120, D181, D182, D183, D184, D185, D186, D187, D188, D189, D190, D191, D192, D193, D194, D195, D196, D197, D198, D199, D200, D261, D262, D263, D264, D265, D266, D267, D268, D269, D270, D271, D272, D273, D274, D275, D276, D277, D278, D279, D280, D341, D342, D343, D344, D345, D346, D347, D348, D349, D350, D351, D352, D353, D354, D355, D356, D357, D358, D359, D360: LED_T1; LED_0402_1005Metric; LCSC Part # C44599418
D41, D42, D43, D44, D45, D46, D47, D48, D49, D50, D51, D52, D53, D54, D55, D56, D57, D58, D59, D60, D121, D122, D123, D124, D125, D126, D127, D128, D129, D130, D131, D132, D133, D134, D135, D136, D137, D138, D139, D140, D201, D202, D203, D204, D205, D206, D207, D208, D209, D210, D211, D212, D213, D214, D215, D216, D217, D218, D219, D220, D281, D282, D283, D284, D285, D286, D287, D288, D289, D290, D291, D292, D293, D294, D295, D296, D297, D298, D299, D300, D361, D362, D363, D364, D365, D366, D367, D368, D369, D370, D371, D372, D373, D374, D375, D376, D377, D378, D379, D380: LED_T2; LED_0402_1005Metric; LCSC Part # C9900325345
D61, D62, D63, D64, D65, D66, D67, D68, D69, D70, D71, D72, D73, D74, D75, D76, D77, D78, D79, D80, D141, D142, D143, D144, D145, D146, D147, D148, D149, D150, D151, D152, D153, D154, D155, D156, D157, D158, D159, D160, D221, D222, D223, D224, D225, D226, D227, D228, D229, D230, D231, D232, D233, D234, D235, D236, D237, D238, D239, D240, D301, D302, D303, D304, D305, D306, D307, D308, D309, D310, D311, D312, D313, D314, D315, D316, D317, D318, D319, D320, D381, D382, D383, D384, D385, D386, D387, D388, D389, D390, D391, D392, D393, D394, D395, D396, D397, D398, D399, D400: LED_T3; LED_0402_1005Metric; LCSC Part # C9900325346
R9, R13, R17, R21, R25: R_T0; R_0402_1005Metric; LCSC Part # C852891
R10, R14, R18, R22, R26: R_T1; R_0402_1005Metric; LCSC Part # C852891
R11, R15, R19, R23, R27: R_T2; R_0402_1005Metric; LCSC Part # C852930
R12, R16, R20, R24, R28: R_T3; R_0402_1005Metric; LCSC Part # C852485

Connections:
/drivers/COL_00: R9.1; also elsewhere on the board
/drivers/COL_01: R10.1; also elsewhere on the board
/drivers/COL_02: R11.1; also elsewhere on the board
/drivers/COL_03: R12.1; also elsewhere on the board
/drivers/COL_04: R13.1; also elsewhere on the board
/drivers/COL_05: R14.1; also elsewhere on the board
/drivers/COL_06: R15.1; also elsewhere on the board
/drivers/COL_07: R16.1; also elsewhere on the board
/drivers/COL_08: R17.1; also elsewhere on the board
/drivers/COL_09: R18.1; also elsewhere on the board
/drivers/COL_10: R19.1; also elsewhere on the board
/drivers/COL_11: R20.1; also elsewhere on the board
/drivers/COL_12: R21.1; also elsewhere on the board
/drivers/COL_13: R22.1; also elsewhere on the board
/drivers/COL_14: R23.1; also elsewhere on the board
/drivers/COL_15: R24.1; also elsewhere on the board
/drivers/COL_16: R25.1; also elsewhere on the board
/drivers/COL_17: R26.1; also elsewhere on the board
/drivers/COL_18: R27.1; also elsewhere on the board
/drivers/COL_19: R28.1; also elsewhere on the board
/drivers/ROW_00: D1.1 (K), D21.1 (K), D41.1 (K), D61.1 (K), D81.1 (K), D101.1 (K), D121.1 (K), D141.1 (K), D161.1 (K), D181.1 (K), D201.1 (K), D221.1 (K), D241.1 (K), D261.1 (K), D281.1 (K), D301.1 (K), D321.1 (K), D341.1 (K), D361.1 (K), D381.1 (K); also elsewhere on the board
/drivers/ROW_01: D2.1 (K), D22.1 (K), D42.1 (K), D62.1 (K), D82.1 (K), D102.1 (K), D122.1 (K), D142.1 (K), D162.1 (K), D182.1 (K), D202.1 (K), D222.1 (K), D242.1 (K), D262.1 (K), D282.1 (K), D302.1 (K), D322.1 (K), D342.1 (K), D362.1 (K), D382.1 (K); also elsewhere on the board
/drivers/ROW_02: D3.1 (K), D23.1 (K), D43.1 (K), D63.1 (K), D83.1 (K), D103.1 (K), D123.1 (K), D143.1 (K), D163.1 (K), D183.1 (K), D203.1 (K), D223.1 (K), D243.1 (K), D263.1 (K), D283.1 (K), D303.1 (K), D323.1 (K), D343.1 (K), D363.1 (K), D383.1 (K); also elsewhere on the board
/drivers/ROW_03: D4.1 (K), D24.1 (K), D44.1 (K), D64.1 (K), D84.1 (K), D104.1 (K), D124.1 (K), D144.1 (K), D164.1 (K), D184.1 (K), D204.1 (K), D224.1 (K), D244.1 (K), D264.1 (K), D284.1 (K), D304.1 (K), D324.1 (K), D344.1 (K), D364.1 (K), D384.1 (K); also elsewhere on the board
/drivers/ROW_04: D5.1 (K), D25.1 (K), D45.1 (K), D65.1 (K), D85.1 (K), D105.1 (K), D125.1 (K), D145.1 (K), D165.1 (K), D185.1 (K), D205.1 (K), D225.1 (K), D245.1 (K), D265.1 (K), D285.1 (K), D305.1 (K), D325.1 (K), D345.1 (K), D365.1 (K), D385.1 (K); also elsewhere on the board
/drivers/ROW_05: D6.1 (K), D26.1 (K), D46.1 (K), D66.1 (K), D86.1 (K), D106.1 (K), D126.1 (K), D146.1 (K), D166.1 (K), D186.1 (K), D206.1 (K), D226.1 (K), D246.1 (K), D266.1 (K), D286.1 (K), D306.1 (K), D326.1 (K), D346.1 (K), D366.1 (K), D386.1 (K); also elsewhere on the board
/drivers/ROW_06: D7.1 (K), D27.1 (K), D47.1 (K), D67.1 (K), D87.1 (K), D107.1 (K), D127.1 (K), D147.1 (K), D167.1 (K), D187.1 (K), D207.1 (K), D227.1 (K), D247.1 (K), D267.1 (K), D287.1 (K), D307.1 (K), D327.1 (K), D347.1 (K), D367.1 (K), D387.1 (K); also elsewhere on the board
/drivers/ROW_07: D8.1 (K), D28.1 (K), D48.1 (K), D68.1 (K), D88.1 (K), D108.1 (K), D128.1 (K), D148.1 (K), D168.1 (K), D188.1 (K), D208.1 (K), D228.1 (K), D248.1 (K), D268.1 (K), D288.1 (K), D308.1 (K), D328.1 (K), D348.1 (K), D368.1 (K), D388.1 (K); also elsewhere on the board
/drivers/ROW_08: D9.1 (K), D29.1 (K), D49.1 (K), D69.1 (K), D89.1 (K), D109.1 (K), D129.1 (K), D149.1 (K), D169.1 (K), D189.1 (K), D209.1 (K), D229.1 (K), D249.1 (K), D269.1 (K), D289.1 (K), D309.1 (K), D329.1 (K), D349.1 (K), D369.1 (K), D389.1 (K); also elsewhere on the board
/drivers/ROW_09: D10.1 (K), D30.1 (K), D50.1 (K), D70.1 (K), D90.1 (K), D110.1 (K), D130.1 (K), D150.1 (K), D170.1 (K), D190.1 (K), D210.1 (K), D230.1 (K), D250.1 (K), D270.1 (K), D290.1 (K), D310.1 (K), D330.1 (K), D350.1 (K), D370.1 (K), D390.1 (K); also elsewhere on the board
/drivers/ROW_10: D11.1 (K), D31.1 (K), D51.1 (K), D71.1 (K), D91.1 (K), D111.1 (K), D131.1 (K), D151.1 (K), D171.1 (K), D191.1 (K), D211.1 (K), D231.1 (K), D251.1 (K), D271.1 (K), D291.1 (K), D311.1 (K), D331.1 (K), D351.1 (K), D371.1 (K), D391.1 (K); also elsewhere on the board
/drivers/ROW_11: D12.1 (K), D32.1 (K), D52.1 (K), D72.1 (K), D92.1 (K), D112.1 (K), D132.1 (K), D152.1 (K), D172.1 (K), D192.1 (K), D212.1 (K), D232.1 (K), D252.1 (K), D272.1 (K), D292.1 (K), D312.1 (K), D332.1 (K), D352.1 (K), D372.1 (K), D392.1 (K); also elsewhere on the board
/drivers/ROW_12: D13.1 (K), D33.1 (K), D53.1 (K), D73.1 (K), D93.1 (K), D113.1 (K), D133.1 (K), D153.1 (K), D173.1 (K), D193.1 (K), D213.1 (K), D233.1 (K), D253.1 (K), D273.1 (K), D293.1 (K), D313.1 (K), D333.1 (K), D353.1 (K), D373.1 (K), D393.1 (K); also elsewhere on the board
/drivers/ROW_13: D14.1 (K), D34.1 (K), D54.1 (K), D74.1 (K), D94.1 (K), D114.1 (K), D134.1 (K), D154.1 (K), D174.1 (K), D194.1 (K), D214.1 (K), D234.1 (K), D254.1 (K), D274.1 (K), D294.1 (K), D314.1 (K), D334.1 (K), D354.1 (K), D374.1 (K), D394.1 (K); also elsewhere on the board
/drivers/ROW_14: D15.1 (K), D35.1 (K), D55.1 (K), D75.1 (K), D95.1 (K), D115.1 (K), D135.1 (K), D155.1 (K), D175.1 (K), D195.1 (K), D215.1 (K), D235.1 (K), D255.1 (K), D275.1 (K), D295.1 (K), D315.1 (K), D335.1 (K), D355.1 (K), D375.1 (K), D395.1 (K); also elsewhere on the board
/drivers/ROW_15: D16.1 (K), D36.1 (K), D56.1 (K), D76.1 (K), D96.1 (K), D116.1 (K), D136.1 (K), D156.1 (K), D176.1 (K), D196.1 (K), D216.1 (K), D236.1 (K), D256.1 (K), D276.1 (K), D296.1 (K), D316.1 (K), D336.1 (K), D356.1 (K), D376.1 (K), D396.1 (K); also elsewhere on the board
/drivers/ROW_16: D17.1 (K), D37.1 (K), D57.1 (K), D77.1 (K), D97.1 (K), D117.1 (K), D137.1 (K), D157.1 (K), D177.1 (K), D197.1 (K), D217.1 (K), D237.1 (K), D257.1 (K), D277.1 (K), D297.1 (K), D317.1 (K), D337.1 (K), D357.1 (K), D377.1 (K), D397.1 (K); also elsewhere on the board
/drivers/ROW_17: D18.1 (K), D38.1 (K), D58.1 (K), D78.1 (K), D98.1 (K), D118.1 (K), D138.1 (K), D158.1 (K), D178.1 (K), D198.1 (K), D218.1 (K), D238.1 (K), D258.1 (K), D278.1 (K), D298.1 (K), D318.1 (K), D338.1 (K), D358.1 (K), D378.1 (K), D398.1 (K); also elsewhere on the board
/drivers/ROW_18: D19.1 (K), D39.1 (K), D59.1 (K), D79.1 (K), D99.1 (K), D119.1 (K), D139.1 (K), D159.1 (K), D179.1 (K), D199.1 (K), D219.1 (K), D239.1 (K), D259.1 (K), D279.1 (K), D299.1 (K), D319.1 (K), D339.1 (K), D359.1 (K), D379.1 (K), D399.1 (K); also elsewhere on the board
/drivers/ROW_19: D20.1 (K), D40.1 (K), D60.1 (K), D80.1 (K), D100.1 (K), D120.1 (K), D140.1 (K), D160.1 (K), D180.1 (K), D200.1 (K), D220.1 (K), D240.1 (K), D260.1 (K), D280.1 (K), D300.1 (K), D320.1 (K), D340.1 (K), D360.1 (K), D380.1 (K), D400.1 (K); also elsewhere on the board
unnamed: D1.2 (A), D2.2 (A), D3.2 (A), D4.2 (A), D5.2 (A), D6.2 (A), D7.2 (A), D8.2 (A), D9.2 (A), D10.2 (A), D11.2 (A), D12.2 (A), D13.2 (A), D14.2 (A), D15.2 (A), D16.2 (A), D17.2 (A), D18.2 (A), D19.2 (A), D20.2 (A), R9.2
unnamed: D21.2 (A), D22.2 (A), D23.2 (A), D24.2 (A), D25.2 (A), D26.2 (A), D27.2 (A), D28.2 (A), D29.2 (A), D30.2 (A), D31.2 (A), D32.2 (A), D33.2 (A), D34.2 (A), D35.2 (A), D36.2 (A), D37.2 (A), D38.2 (A), D39.2 (A), D40.2 (A), R10.2
unnamed: D41.2 (A), D42.2 (A), D43.2 (A), D44.2 (A), D45.2 (A), D46.2 (A), D47.2 (A), D48.2 (A), D49.2 (A), D50.2 (A), D51.2 (A), D52.2 (A), D53.2 (A), D54.2 (A), D55.2 (A), D56.2 (A), D57.2 (A), D58.2 (A), D59.2 (A), D60.2 (A), R11.2
unnamed: D61.2 (A), D62.2 (A), D63.2 (A), D64.2 (A), D65.2 (A), D66.2 (A), D67.2 (A), D68.2 (A), D69.2 (A), D70.2 (A), D71.2 (A), D72.2 (A), D73.2 (A), D74.2 (A), D75.2 (A), D76.2 (A), D77.2 (A), D78.2 (A), D79.2 (A), D80.2 (A), R12.2
unnamed: D81.2 (A), D82.2 (A), D83.2 (A), D84.2 (A), D85.2 (A), D86.2 (A), D87.2 (A), D88.2 (A), D89.2 (A), D90.2 (A), D91.2 (A), D92.2 (A), D93.2 (A), D94.2 (A), D95.2 (A), D96.2 (A), D97.2 (A), D98.2 (A), D99.2 (A), D100.2 (A), R13.2
unnamed: D101.2 (A), D102.2 (A), D103.2 (A), D104.2 (A), D105.2 (A), D106.2 (A), D107.2 (A), D108.2 (A), D109.2 (A), D110.2 (A), D111.2 (A), D112.2 (A), D113.2 (A), D114.2 (A), D115.2 (A), D116.2 (A), D117.2 (A), D118.2 (A), D119.2 (A), D120.2 (A), R14.2
unnamed: D121.2 (A), D122.2 (A), D123.2 (A), D124.2 (A), D125.2 (A), D126.2 (A), D127.2 (A), D128.2 (A), D129.2 (A), D130.2 (A), D131.2 (A), D132.2 (A), D133.2 (A), D134.2 (A), D135.2 (A), D136.2 (A), D137.2 (A), D138.2 (A), D139.2 (A), D140.2 (A), R15.2
unnamed: D141.2 (A), D142.2 (A), D143.2 (A), D144.2 (A), D145.2 (A), D146.2 (A), D147.2 (A), D148.2 (A), D149.2 (A), D150.2 (A), D151.2 (A), D152.2 (A), D153.2 (A), D154.2 (A), D155.2 (A), D156.2 (A), D157.2 (A), D158.2 (A), D159.2 (A), D160.2 (A), R16.2
unnamed: D161.2 (A), D162.2 (A), D163.2 (A), D164.2 (A), D165.2 (A), D166.2 (A), D167.2 (A), D168.2 (A), D169.2 (A), D170.2 (A), D171.2 (A), D172.2 (A), D173.2 (A), D174.2 (A), D175.2 (A), D176.2 (A), D177.2 (A), D178.2 (A), D179.2 (A), D180.2 (A), R17.2
unnamed: D181.2 (A), D182.2 (A), D183.2 (A), D184.2 (A), D185.2 (A), D186.2 (A), D187.2 (A), D188.2 (A), D189.2 (A), D190.2 (A), D191.2 (A), D192.2 (A), D193.2 (A), D194.2 (A), D195.2 (A), D196.2 (A), D197.2 (A), D198.2 (A), D199.2 (A), D200.2 (A), R18.2
unnamed: D201.2 (A), D202.2 (A), D203.2 (A), D204.2 (A), D205.2 (A), D206.2 (A), D207.2 (A), D208.2 (A), D209.2 (A), D210.2 (A), D211.2 (A), D212.2 (A), D213.2 (A), D214.2 (A), D215.2 (A), D216.2 (A), D217.2 (A), D218.2 (A), D219.2 (A), D220.2 (A), R19.2
unnamed: D221.2 (A), D222.2 (A), D223.2 (A), D224.2 (A), D225.2 (A), D226.2 (A), D227.2 (A), D228.2 (A), D229.2 (A), D230.2 (A), D231.2 (A), D232.2 (A), D233.2 (A), D234.2 (A), D235.2 (A), D236.2 (A), D237.2 (A), D238.2 (A), D239.2 (A), D240.2 (A), R20.2
unnamed: D241.2 (A), D242.2 (A), D243.2 (A), D244.2 (A), D245.2 (A), D246.2 (A), D247.2 (A), D248.2 (A), D249.2 (A), D250.2 (A), D251.2 (A), D252.2 (A), D253.2 (A), D254.2 (A), D255.2 (A), D256.2 (A), D257.2 (A), D258.2 (A), D259.2 (A), D260.2 (A), R21.2
unnamed: D261.2 (A), D262.2 (A), D263.2 (A), D264.2 (A), D265.2 (A), D266.2 (A), D267.2 (A), D268.2 (A), D269.2 (A), D270.2 (A), D271.2 (A), D272.2 (A), D273.2 (A), D274.2 (A), D275.2 (A), D276.2 (A), D277.2 (A), D278.2 (A), D279.2 (A), D280.2 (A), R22.2
unnamed: D281.2 (A), D282.2 (A), D283.2 (A), D284.2 (A), D285.2 (A), D286.2 (A), D287.2 (A), D288.2 (A), D289.2 (A), D290.2 (A), D291.2 (A), D292.2 (A), D293.2 (A), D294.2 (A), D295.2 (A), D296.2 (A), D297.2 (A), D298.2 (A), D299.2 (A), D300.2 (A), R23.2
unnamed: D301.2 (A), D302.2 (A), D303.2 (A), D304.2 (A), D305.2 (A), D306.2 (A), D307.2 (A), D308.2 (A), D309.2 (A), D310.2 (A), D311.2 (A), D312.2 (A), D313.2 (A), D314.2 (A), D315.2 (A), D316.2 (A), D317.2 (A), D318.2 (A), D319.2 (A), D320.2 (A), R24.2
unnamed: D321.2 (A), D322.2 (A), D323.2 (A), D324.2 (A), D325.2 (A), D326.2 (A), D327.2 (A), D328.2 (A), D329.2 (A), D330.2 (A), D331.2 (A), D332.2 (A), D333.2 (A), D334.2 (A), D335.2 (A), D336.2 (A), D337.2 (A), D338.2 (A), D339.2 (A), D340.2 (A), R25.2
unnamed: D341.2 (A), D342.2 (A), D343.2 (A), D344.2 (A), D345.2 (A), D346.2 (A), D347.2 (A), D348.2 (A), D349.2 (A), D350.2 (A), D351.2 (A), D352.2 (A), D353.2 (A), D354.2 (A), D355.2 (A), D356.2 (A), D357.2 (A), D358.2 (A), D359.2 (A), D360.2 (A), R26.2
unnamed: D361.2 (A), D362.2 (A), D363.2 (A), D364.2 (A), D365.2 (A), D366.2 (A), D367.2 (A), D368.2 (A), D369.2 (A), D370.2 (A), D371.2 (A), D372.2 (A), D373.2 (A), D374.2 (A), D375.2 (A), D376.2 (A), D377.2 (A), D378.2 (A), D379.2 (A), D380.2 (A), R27.2
unnamed: D381.2 (A), D382.2 (A), D383.2 (A), D384.2 (A), D385.2 (A), D386.2 (A), D387.2 (A), D388.2 (A), D389.2 (A), D390.2 (A), D391.2 (A), D392.2 (A), D393.2 (A), D394.2 (A), D395.2 (A), D396.2 (A), D397.2 (A), D398.2 (A), D399.2 (A), D400.2 (A), R28.2

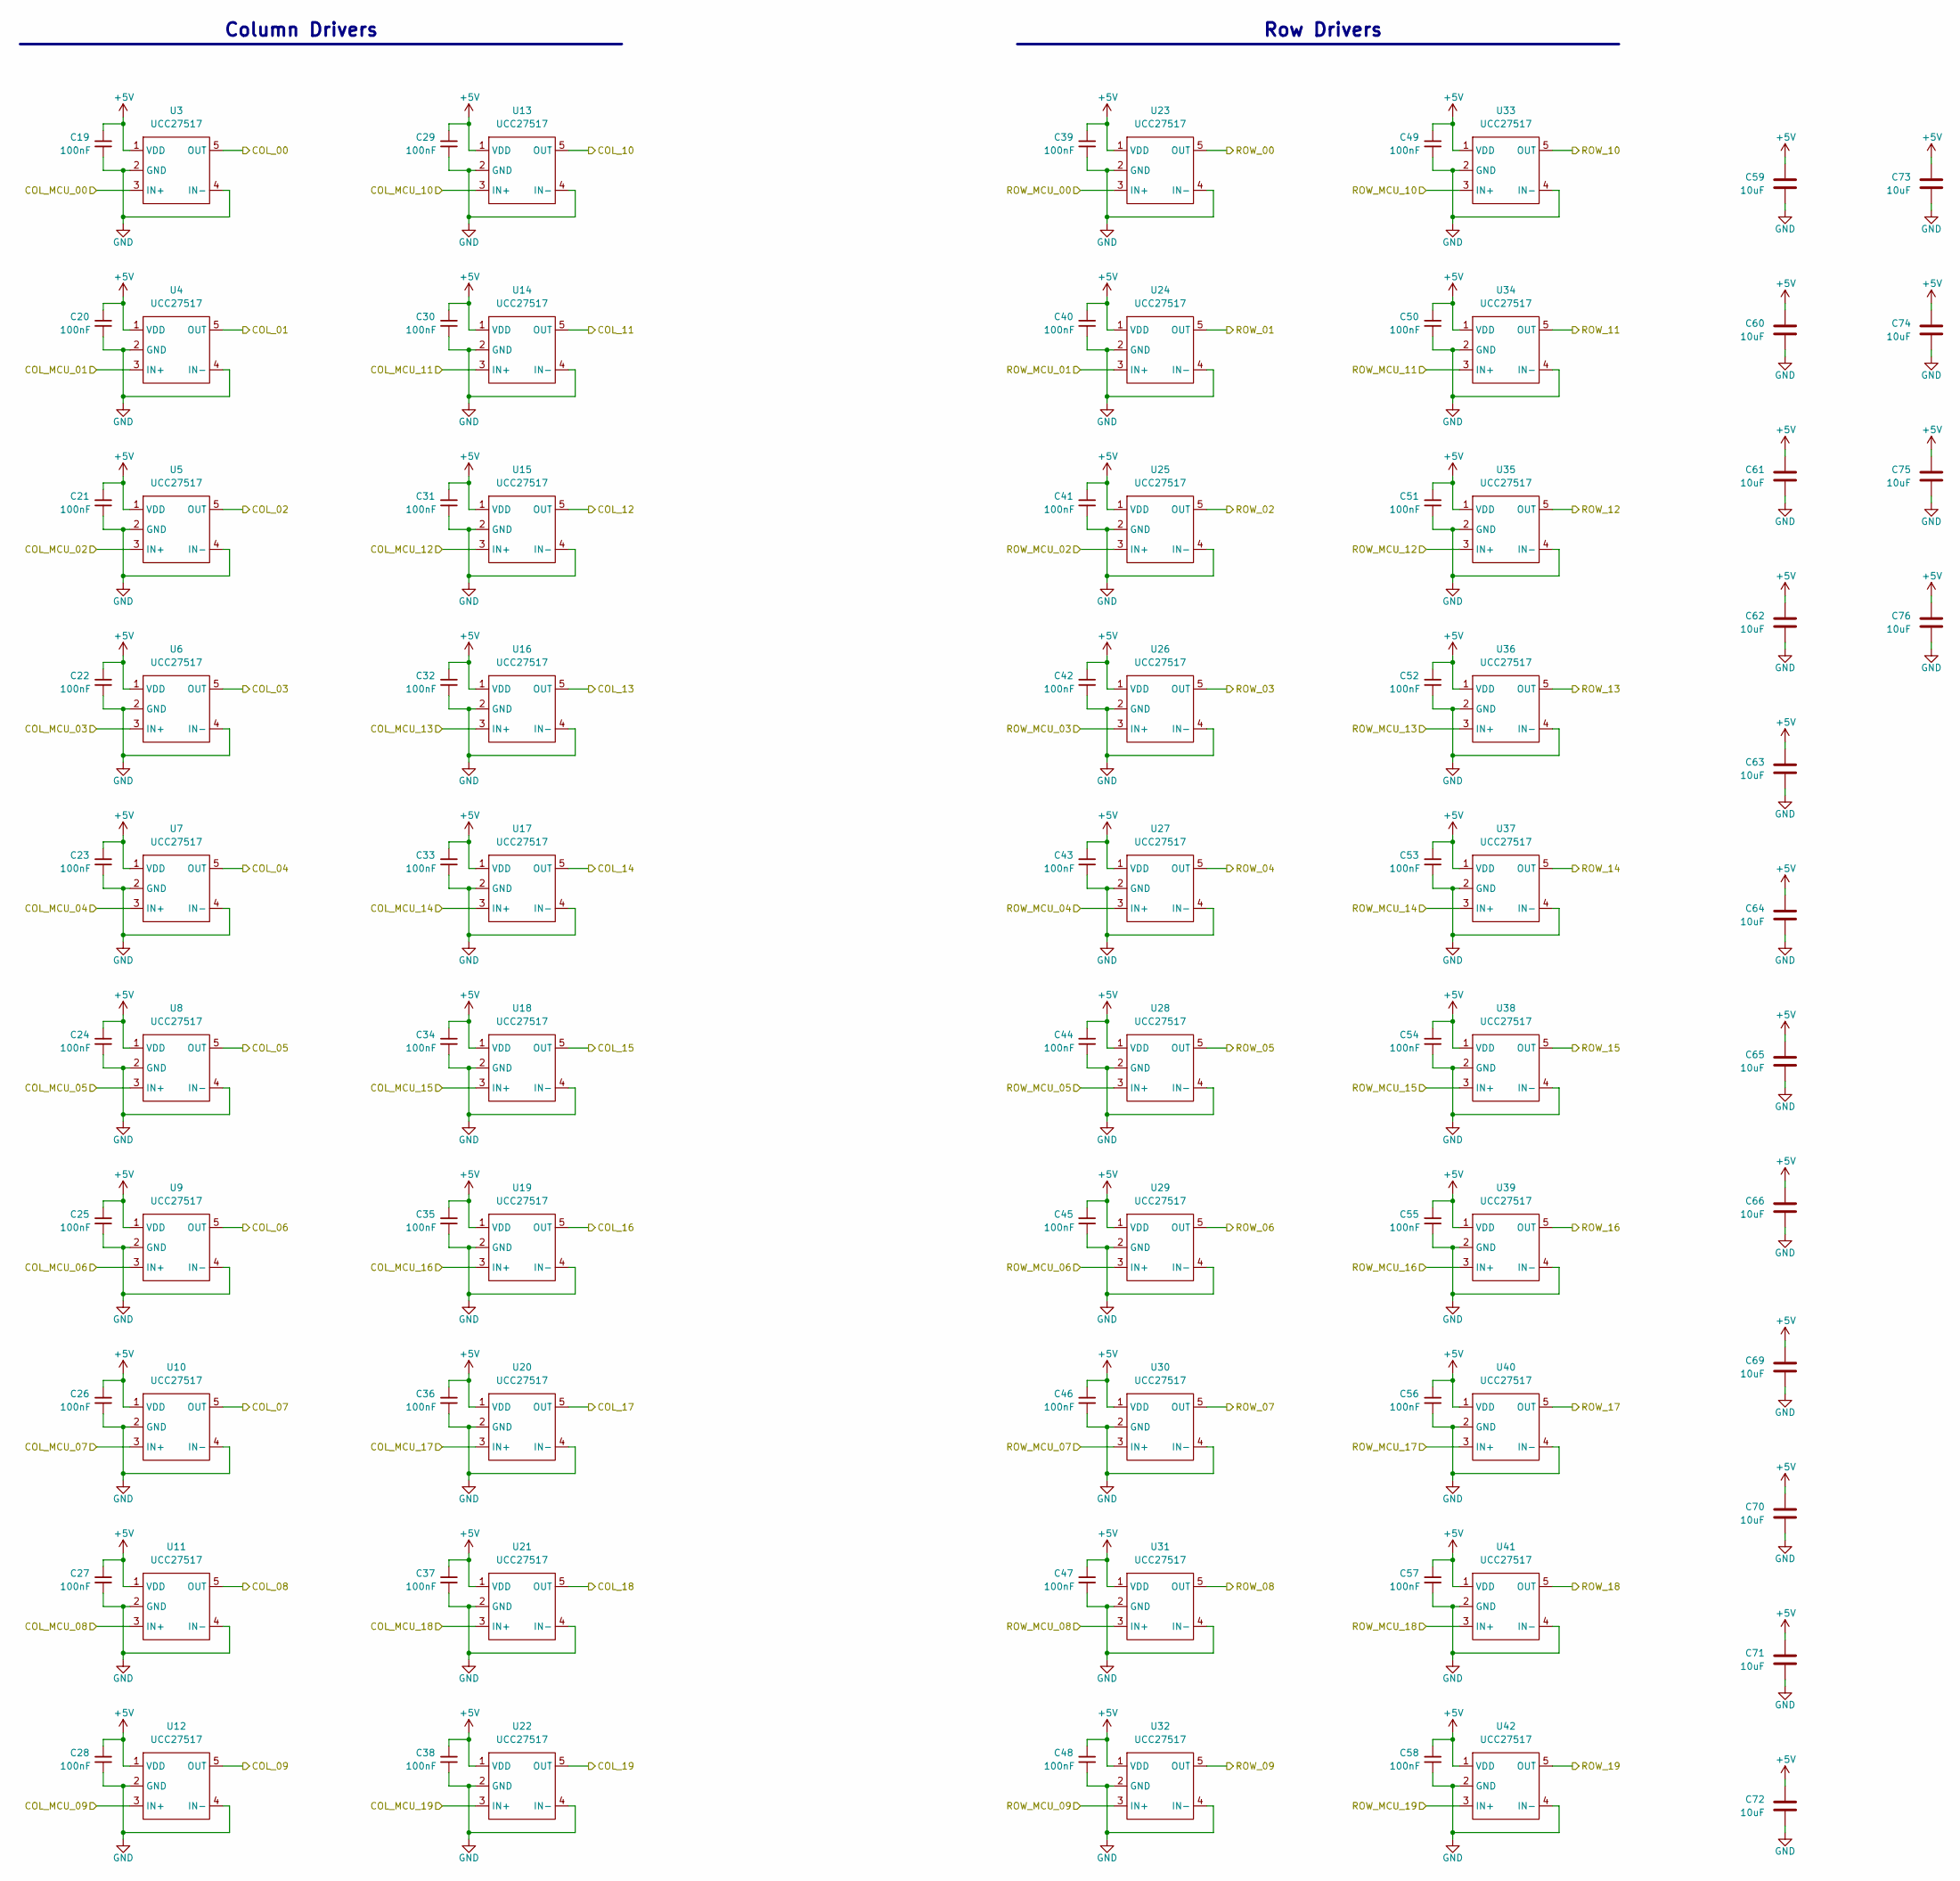
[picture p34: schematic drivers.kicad_sch, G6 PBYR 45mm RP2354]

Parts:
C19, C20, C21, C22, C23, C24, C25, C26, C27, C28, C29, C30, C31, C32, C33, C34, C35, C36, C37, C38, C39, C40, C41, C42, C43, C44, C45, C46, C47, C48, C49, C50, C51, C52, C53, C54, C55, C56, C57, C58: 100nF; C_0201_0603Metric; LCSC Part # C76939
C59, C60, C61, C62, C63, C64, C65, C66, C69, C70, C71, C72, C73, C74, C75, C76: 10uF; C_0402_1005Metric; LCSC Part # C315248
U3, U4, U5, U6, U7, U8, U9, U10, U11, U12, U13, U14, U15, U16, U17, U18, U19, U20, U21, U22, U23, U24, U25, U26, U27, U28, U29, U30, U31, U32, U33, U34, U35, U36, U37, U38, U39, U40, U41, U42: UCC27517; SOT-23-5; LCSC Part # C99395

Connections:
+5V: C19.1, C20.1, C21.1, C22.1, C23.1, C24.1, C25.1, C26.1, C27.1, C28.1, C29.1, C30.1, C31.1, C32.1, C33.1, C34.1, C35.1, C36.1, C37.1, C38.1, C39.1, C40.1, C41.1, C42.1, C43.1, C44.1, C45.1, C46.1, C47.1, C48.1, C49.1, C50.1, C51.1, C52.1, C53.1, C54.1, C55.1, C56.1, C57.1, C58.1, C59.1, C60.1, C61.1, C62.1, C63.1, C64.1, C65.1, C66.1, C69.1, C70.1, C71.1, C72.1, C73.1, C74.1, C75.1, C76.1, U3.1 (VDD), U4.1 (VDD), U5.1 (VDD), U6.1 (VDD), U7.1 (VDD), U8.1 (VDD), U9.1 (VDD), U10.1 (VDD), U11.1 (VDD), U12.1 (VDD), U13.1 (VDD), U14.1 (VDD), U15.1 (VDD), U16.1 (VDD), U17.1 (VDD), U18.1 (VDD), U19.1 (VDD), U20.1 (VDD), U21.1 (VDD), U22.1 (VDD), U23.1 (VDD), U24.1 (VDD), U25.1 (VDD), U26.1 (VDD), U27.1 (VDD), U28.1 (VDD), U29.1 (VDD), U30.1 (VDD), U31.1 (VDD), U32.1 (VDD), U33.1 (VDD), U34.1 (VDD), U35.1 (VDD), U36.1 (VDD), U37.1 (VDD), U38.1 (VDD), U39.1 (VDD), U40.1 (VDD), U41.1 (VDD), U42.1 (VDD); also elsewhere on the board
/drivers/COL_00: U3.5 (OUT); also elsewhere on the board
/drivers/COL_01: U4.5 (OUT); also elsewhere on the board
/drivers/COL_02: U5.5 (OUT); also elsewhere on the board
/drivers/COL_03: U6.5 (OUT); also elsewhere on the board
/drivers/COL_04: U7.5 (OUT); also elsewhere on the board
/drivers/COL_05: U8.5 (OUT); also elsewhere on the board
/drivers/COL_06: U9.5 (OUT); also elsewhere on the board
/drivers/COL_07: U10.5 (OUT); also elsewhere on the board
/drivers/COL_08: U11.5 (OUT); also elsewhere on the board
/drivers/COL_09: U12.5 (OUT); also elsewhere on the board
/drivers/COL_10: U13.5 (OUT); also elsewhere on the board
/drivers/COL_11: U14.5 (OUT); also elsewhere on the board
/drivers/COL_12: U15.5 (OUT); also elsewhere on the board
/drivers/COL_13: U16.5 (OUT); also elsewhere on the board
/drivers/COL_14: U17.5 (OUT); also elsewhere on the board
/drivers/COL_15: U18.5 (OUT); also elsewhere on the board
/drivers/COL_16: U19.5 (OUT); also elsewhere on the board
/drivers/COL_17: U20.5 (OUT); also elsewhere on the board
/drivers/COL_18: U21.5 (OUT); also elsewhere on the board
/drivers/COL_19: U22.5 (OUT); also elsewhere on the board
/drivers/COL_MCU_00: U3.3 (IN+); also elsewhere on the board
/drivers/COL_MCU_01: U4.3 (IN+); also elsewhere on the board
/drivers/COL_MCU_02: U5.3 (IN+); also elsewhere on the board
/drivers/COL_MCU_03: U6.3 (IN+); also elsewhere on the board
/drivers/COL_MCU_04: U7.3 (IN+); also elsewhere on the board
/drivers/COL_MCU_05: U8.3 (IN+); also elsewhere on the board
/drivers/COL_MCU_06: U9.3 (IN+); also elsewhere on the board
/drivers/COL_MCU_07: U10.3 (IN+); also elsewhere on the board
/drivers/COL_MCU_08: U11.3 (IN+); also elsewhere on the board
/drivers/COL_MCU_09: U12.3 (IN+); also elsewhere on the board
/drivers/COL_MCU_10: U13.3 (IN+); also elsewhere on the board
/drivers/COL_MCU_11: U14.3 (IN+); also elsewhere on the board
/drivers/COL_MCU_12: U15.3 (IN+); also elsewhere on the board
/drivers/COL_MCU_13: U16.3 (IN+); also elsewhere on the board
/drivers/COL_MCU_14: U17.3 (IN+); also elsewhere on the board
/drivers/COL_MCU_15: U18.3 (IN+); also elsewhere on the board
/drivers/COL_MCU_16: U19.3 (IN+); also elsewhere on the board
/drivers/COL_MCU_17: U20.3 (IN+); also elsewhere on the board
/drivers/COL_MCU_18: U21.3 (IN+); also elsewhere on the board
/drivers/COL_MCU_19: U22.3 (IN+); also elsewhere on the board
/drivers/ROW_00: U23.5 (OUT); also elsewhere on the board
/drivers/ROW_01: U24.5 (OUT); also elsewhere on the board
/drivers/ROW_02: U25.5 (OUT); also elsewhere on the board
/drivers/ROW_03: U26.5 (OUT); also elsewhere on the board
/drivers/ROW_04: U27.5 (OUT); also elsewhere on the board
/drivers/ROW_05: U28.5 (OUT); also elsewhere on the board
/drivers/ROW_06: U29.5 (OUT); also elsewhere on the board
/drivers/ROW_07: U30.5 (OUT); also elsewhere on the board
/drivers/ROW_08: U31.5 (OUT); also elsewhere on the board
/drivers/ROW_09: U32.5 (OUT); also elsewhere on the board
/drivers/ROW_10: U33.5 (OUT); also elsewhere on the board
/drivers/ROW_11: U34.5 (OUT); also elsewhere on the board
/drivers/ROW_12: U35.5 (OUT); also elsewhere on the board
/drivers/ROW_13: U36.5 (OUT); also elsewhere on the board
/drivers/ROW_14: U37.5 (OUT); also elsewhere on the board
/drivers/ROW_15: U38.5 (OUT); also elsewhere on the board
/drivers/ROW_16: U39.5 (OUT); also elsewhere on the board
/drivers/ROW_17: U40.5 (OUT); also elsewhere on the board
/drivers/ROW_18: U41.5 (OUT); also elsewhere on the board
/drivers/ROW_19: U42.5 (OUT); also elsewhere on the board
/drivers/ROW_MCU_00: U23.3 (IN+); also elsewhere on the board
/drivers/ROW_MCU_01: U24.3 (IN+); also elsewhere on the board
/drivers/ROW_MCU_02: U25.3 (IN+); also elsewhere on the board
/drivers/ROW_MCU_03: U26.3 (IN+); also elsewhere on the board
/drivers/ROW_MCU_04: U27.3 (IN+); also elsewhere on the board
/drivers/ROW_MCU_05: U28.3 (IN+); also elsewhere on the board
/drivers/ROW_MCU_06: U29.3 (IN+); also elsewhere on the board
/drivers/ROW_MCU_07: U30.3 (IN+); also elsewhere on the board
/drivers/ROW_MCU_08: U31.3 (IN+); also elsewhere on the board
/drivers/ROW_MCU_09: U32.3 (IN+); also elsewhere on the board
/drivers/ROW_MCU_10: U33.3 (IN+); also elsewhere on the board
/drivers/ROW_MCU_11: U34.3 (IN+); also elsewhere on the board
/drivers/ROW_MCU_12: U35.3 (IN+); also elsewhere on the board
/drivers/ROW_MCU_13: U36.3 (IN+); also elsewhere on the board
/drivers/ROW_MCU_14: U37.3 (IN+); also elsewhere on the board
/drivers/ROW_MCU_15: U38.3 (IN+); also elsewhere on the board
/drivers/ROW_MCU_16: U39.3 (IN+); also elsewhere on the board
/drivers/ROW_MCU_17: U40.3 (IN+); also elsewhere on the board
/drivers/ROW_MCU_18: U41.3 (IN+); also elsewhere on the board
/drivers/ROW_MCU_19: U42.3 (IN+); also elsewhere on the board
GND: C19.2, C20.2, C21.2, C22.2, C23.2, C24.2, C25.2, C26.2, C27.2, C28.2, C29.2, C30.2, C31.2, C32.2, C33.2, C34.2, C35.2, C36.2, C37.2, C38.2, C39.2, C40.2, C41.2, C42.2, C43.2, C44.2, C45.2, C46.2, C47.2, C48.2, C49.2, C50.2, C51.2, C52.2, C53.2, C54.2, C55.2, C56.2, C57.2, C58.2, C59.2, C60.2, C61.2, C62.2, C63.2, C64.2, C65.2, C66.2, C69.2, C70.2, C71.2, C72.2, C73.2, C74.2, C75.2, C76.2, U3.2 (GND), U3.4 (IN-), U4.2 (GND), U4.4 (IN-), U5.2 (GND), U5.4 (IN-), U6.2 (GND), U6.4 (IN-), U7.2 (GND), U7.4 (IN-), U8.2 (GND), U8.4 (IN-), U9.2 (GND), U9.4 (IN-), U10.2 (GND), U10.4 (IN-), U11.2 (GND), U11.4 (IN-), U12.2 (GND), U12.4 (IN-), U13.2 (GND), U13.4 (IN-), U14.2 (GND), U14.4 (IN-), U15.2 (GND), U15.4 (IN-), U16.2 (GND), U16.4 (IN-), U17.2 (GND), U17.4 (IN-), U18.2 (GND), U18.4 (IN-), U19.2 (GND), U19.4 (IN-), U20.2 (GND), U20.4 (IN-), U21.2 (GND), U21.4 (IN-), U22.2 (GND), U22.4 (IN-), U23.2 (GND), U23.4 (IN-), U24.2 (GND), U24.4 (IN-), U25.2 (GND), U25.4 (IN-), U26.2 (GND), U26.4 (IN-), U27.2 (GND), U27.4 (IN-), U28.2 (GND), U28.4 (IN-), U29.2 (GND), U29.4 (IN-), U30.2 (GND), U30.4 (IN-), U31.2 (GND), U31.4 (IN-), U32.2 (GND), U32.4 (IN-), U33.2 (GND), U33.4 (IN-), U34.2 (GND), U34.4 (IN-), U35.2 (GND), U35.4 (IN-), U36.2 (GND), U36.4 (IN-), U37.2 (GND), U37.4 (IN-), U38.2 (GND), U38.4 (IN-), U39.2 (GND), U39.4 (IN-), U40.2 (GND), U40.4 (IN-), U41.2 (GND), U41.4 (IN-), U42.2 (GND), U42.4 (IN-); also elsewhere on the board

Notes on the sheet:
Column Drivers
Row Drivers
