reiserlab/LED-Display_G6_Hardware_Panel/panel_rp2354_20x20_four-color_v0p5/panel_rp2354_20x20.kicad_pcb

## KiCad design panel_rp2354_20x20_four-color_v0p5/panel_rp2354_20x20.kicad_pcb (continued)

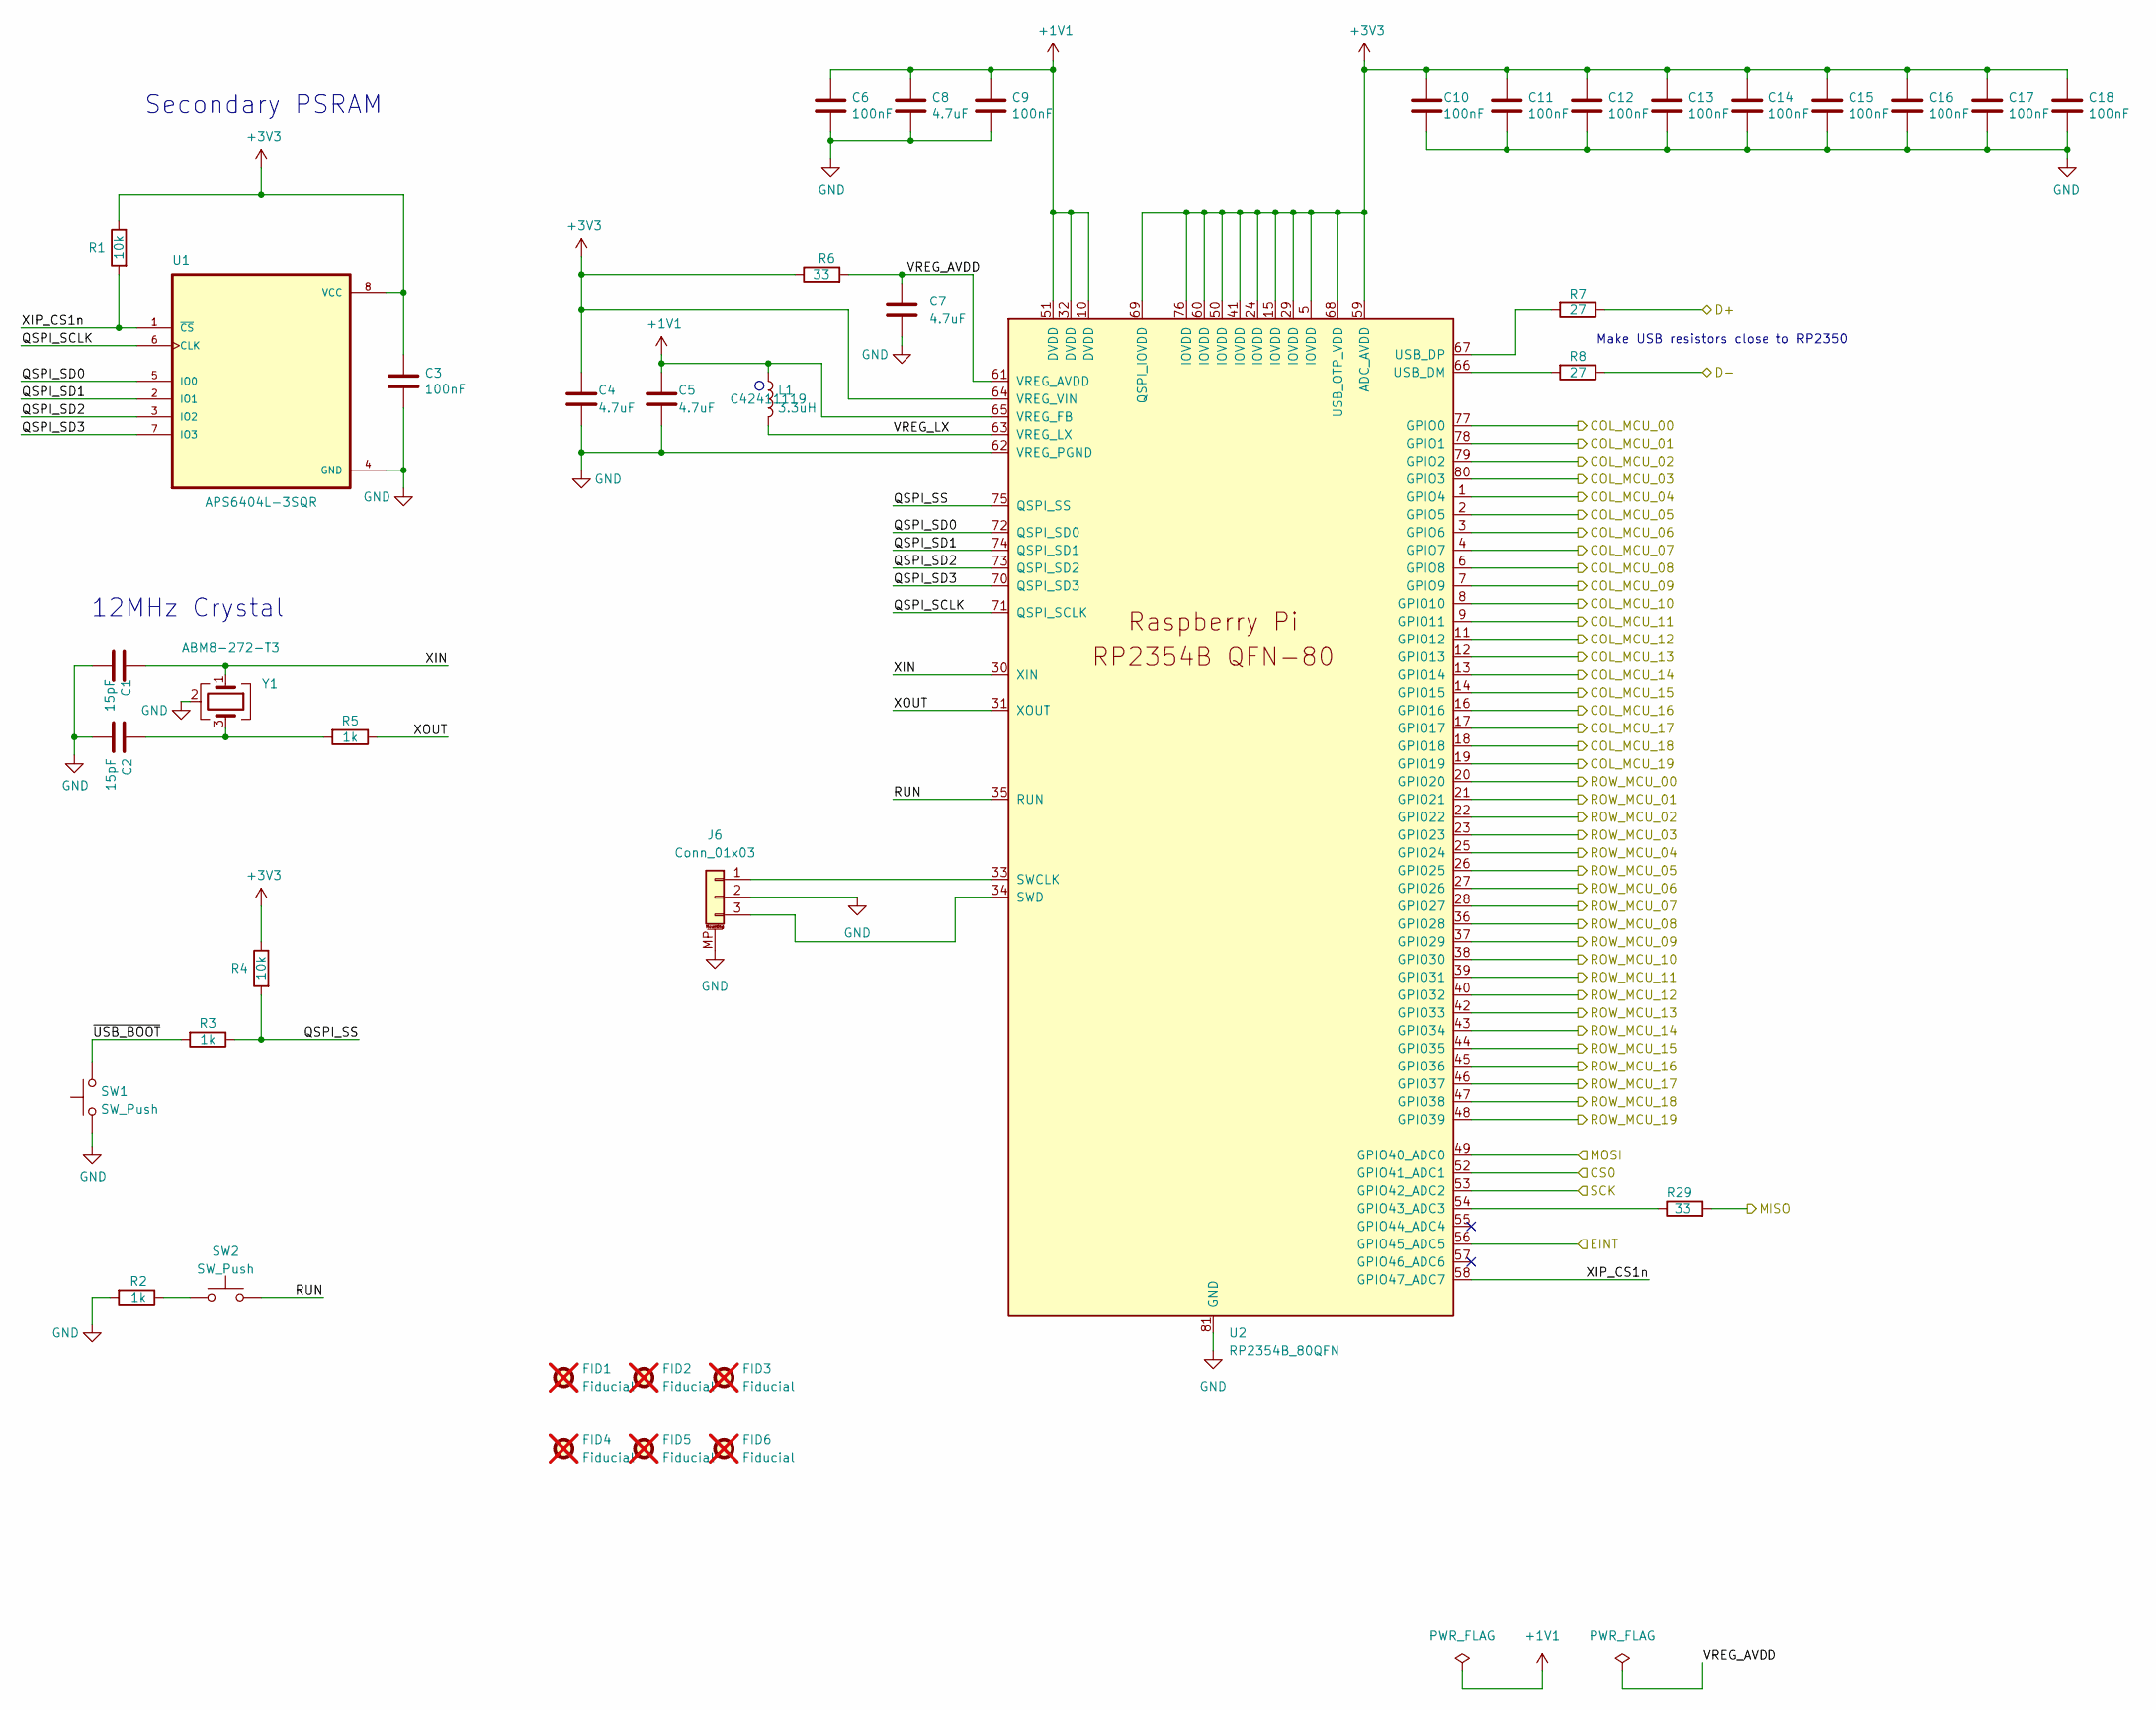
[picture p35: schematic panel_mcu.kicad_sch, G6 PBYR 45mm RP2354]

Parts:
C1, C2: 15pF; C_0201_0603Metric; LCSC Part # C541259
C3, C6, C9, C10, C11, C12, C13, C14, C15, C16, C17, C18: 100nF; C_0201_0603Metric; LCSC Part # C76939
C4, C5: 4.7uF; C_0402_1005Metric_small_pads; LCSC Part # C368809
C7, C8: 4.7uF; C_0402_1005Metric; LCSC Part # C368809
FID1, FID2, FID3, FID4, FID5, FID6: Fiducial; Fiducial_0.5mm_Mask1mm; not fitted
J6: Conn_01x03; JST_SH_BM03B-SRSS-TB_1x03-1MP_P1.00mm_Vertical; LCSC Part # C160389
L1: 3.3uH; L_pol_2016; LCSC Part # C42411119
R1, R4: 10k; R_0201_0603Metric; LCSC Part # C473048
R2, R3, R5: 1k; R_0201_0603Metric; LCSC Part # C270365
R6, R29: 33; R_0201_0603Metric; LCSC Part # C295794
R7, R8: 27; R_0201_0603Metric; LCSC Part # C473051
SW1, SW2: SW_Push; TS-1088-AR02016; LCSC Part # C720477
U1: APS6404L-3SQR; flashmem_PSON50P300X200X60-9N; LCSC Part # C3040877
U2: RP2354B_80QFN; RP2350-QFN-80-1EP_10x10_P0.4mm_EP3.4x3.4mm_ThermalVias; LCSC Part # C39843328
Y1: ABM8-272-T3; Crystal_SMD_3225-4Pin_3.2x2.5mm; LCSC Part # C20625731

Connections:
+1V1: C5.1, C6.1, C8.1, C9.1, L1.1, U2.10 (DVDD), U2.32 (DVDD), U2.51 (DVDD), U2.65 (VREG_FB)
+3V3: C3.1, C4.1, C10.1, C11.1, C12.1, C13.1, C14.1, C15.1, C16.1, C17.1, C18.1, R1.1, R4.1, R6.1, U1.8 (VCC), U2.5 (IOVDD), U2.15 (IOVDD), U2.24 (IOVDD), U2.29 (IOVDD), U2.41 (IOVDD), U2.50 (IOVDD), U2.59 (ADC_AVDD), U2.60 (IOVDD), U2.64 (VREG_VIN), U2.68 (USB_OTP_VDD), U2.69 (QSPI_IOVDD), U2.76 (IOVDD); also elsewhere on the board
/drivers/COL_MCU_00: U2.77 (GPIO0); also elsewhere on the board
/drivers/COL_MCU_01: U2.78 (GPIO1); also elsewhere on the board
/drivers/COL_MCU_02: U2.79 (GPIO2); also elsewhere on the board
/drivers/COL_MCU_03: U2.80 (GPIO3); also elsewhere on the board
/drivers/COL_MCU_04: U2.1 (GPIO4); also elsewhere on the board
/drivers/COL_MCU_05: U2.2 (GPIO5); also elsewhere on the board
/drivers/COL_MCU_06: U2.3 (GPIO6); also elsewhere on the board
/drivers/COL_MCU_07: U2.4 (GPIO7); also elsewhere on the board
/drivers/COL_MCU_08: U2.6 (GPIO8); also elsewhere on the board
/drivers/COL_MCU_09: U2.7 (GPIO9); also elsewhere on the board
/drivers/COL_MCU_10: U2.8 (GPIO10); also elsewhere on the board
/drivers/COL_MCU_11: U2.9 (GPIO11); also elsewhere on the board
/drivers/COL_MCU_12: U2.11 (GPIO12); also elsewhere on the board
/drivers/COL_MCU_13: U2.12 (GPIO13); also elsewhere on the board
/drivers/COL_MCU_14: U2.13 (GPIO14); also elsewhere on the board
/drivers/COL_MCU_15: U2.14 (GPIO15); also elsewhere on the board
/drivers/COL_MCU_16: U2.16 (GPIO16); also elsewhere on the board
/drivers/COL_MCU_17: U2.17 (GPIO17); also elsewhere on the board
/drivers/COL_MCU_18: U2.18 (GPIO18); also elsewhere on the board
/drivers/COL_MCU_19: U2.19 (GPIO19); also elsewhere on the board
/drivers/ROW_MCU_00: U2.20 (GPIO20); also elsewhere on the board
/drivers/ROW_MCU_01: U2.21 (GPIO21); also elsewhere on the board
/drivers/ROW_MCU_02: U2.22 (GPIO22); also elsewhere on the board
/drivers/ROW_MCU_03: U2.23 (GPIO23); also elsewhere on the board
/drivers/ROW_MCU_04: U2.25 (GPIO24); also elsewhere on the board
/drivers/ROW_MCU_05: U2.26 (GPIO25); also elsewhere on the board
/drivers/ROW_MCU_06: U2.27 (GPIO26); also elsewhere on the board
/drivers/ROW_MCU_07: U2.28 (GPIO27); also elsewhere on the board
/drivers/ROW_MCU_08: U2.36 (GPIO28); also elsewhere on the board
/drivers/ROW_MCU_09: U2.37 (GPIO29); also elsewhere on the board
/drivers/ROW_MCU_10: U2.38 (GPIO30); also elsewhere on the board
/drivers/ROW_MCU_11: U2.39 (GPIO31); also elsewhere on the board
/drivers/ROW_MCU_12: U2.40 (GPIO32); also elsewhere on the board
/drivers/ROW_MCU_13: U2.42 (GPIO33); also elsewhere on the board
/drivers/ROW_MCU_14: U2.43 (GPIO34); also elsewhere on the board
/drivers/ROW_MCU_15: U2.44 (GPIO35); also elsewhere on the board
/drivers/ROW_MCU_16: U2.45 (GPIO36); also elsewhere on the board
/drivers/ROW_MCU_17: U2.46 (GPIO37); also elsewhere on the board
/drivers/ROW_MCU_18: U2.47 (GPIO38); also elsewhere on the board
/drivers/ROW_MCU_19: U2.48 (GPIO39); also elsewhere on the board
/panel_header/CS0: U2.52 (GPIO41_ADC1); also elsewhere on the board
/panel_header/EINT: U2.56 (GPIO45_ADC5); also elsewhere on the board
/panel_header/MISO: R29.2; also elsewhere on the board
/panel_header/MOSI: U2.49 (GPIO40_ADC0); also elsewhere on the board
/panel_header/SCK: U2.53 (GPIO42_ADC2); also elsewhere on the board
/panel_mcu/D+: R7.1; also elsewhere on the board
/panel_mcu/D-: R8.1; also elsewhere on the board
/panel_mcu/QSPI_SCLK: U1.6 (CLK), U2.71 (QSPI_SCLK)
/panel_mcu/QSPI_SD0: U1.5 (IO0), U2.72 (QSPI_SD0)
/panel_mcu/QSPI_SD1: U1.2 (IO1), U2.74 (QSPI_SD1)
/panel_mcu/QSPI_SD2: U1.3 (IO2), U2.73 (QSPI_SD2)
/panel_mcu/QSPI_SD3: U1.7 (IO3), U2.70 (QSPI_SD3)
/panel_mcu/QSPI_SS: R3.1, R4.2, U2.75 (QSPI_SS)
/panel_mcu/RUN: SW2.2, U2.35 (RUN)
/panel_mcu/VREG_AVDD: C7.1, R6.2, U2.61 (VREG_AVDD)
/panel_mcu/VREG_LX: L1.2, U2.63 (VREG_LX)
/panel_mcu/XIN: C1.1, U2.30 (XIN), Y1.1
/panel_mcu/XIP_CS1n: R1.2, U1.1 (~CS), U2.58 (GPIO47_ADC7)
/panel_mcu/XOUT: R5.1, U2.31 (XOUT)
/panel_mcu/~USB_BOOT: R3.2, SW1.2
GND: C1.2, C2.2, C3.2, C4.2, C5.2, C6.2, C7.2, C8.2, C9.2, C10.2, C11.2, C12.2, C13.2, C14.2, C15.2, C16.2, C17.2, C18.2, J6.2, J6.MP (MountPin), R2.2, SW1.1, U1.4 (GND), U2.62 (VREG_PGND), U2.81 (GND), Y1.2 (G), Y1.4 (G); also elsewhere on the board
unnamed: C2.1, R5.2, Y1.3
unnamed: J6.1, U2.33 (SWCLK)
unnamed: J6.3, U2.34 (SWD)
unnamed: R2.1, SW2.1
unnamed: R29.1, U2.54 (GPIO43_ADC3)
unnamed: R8.2, U2.66 (USB_DM)
unnamed: R7.2, U2.67 (USB_DP)

Notes on the sheet:
12MHz Crystal
Secondary PSRAM
Make USB resistors close to RP2350

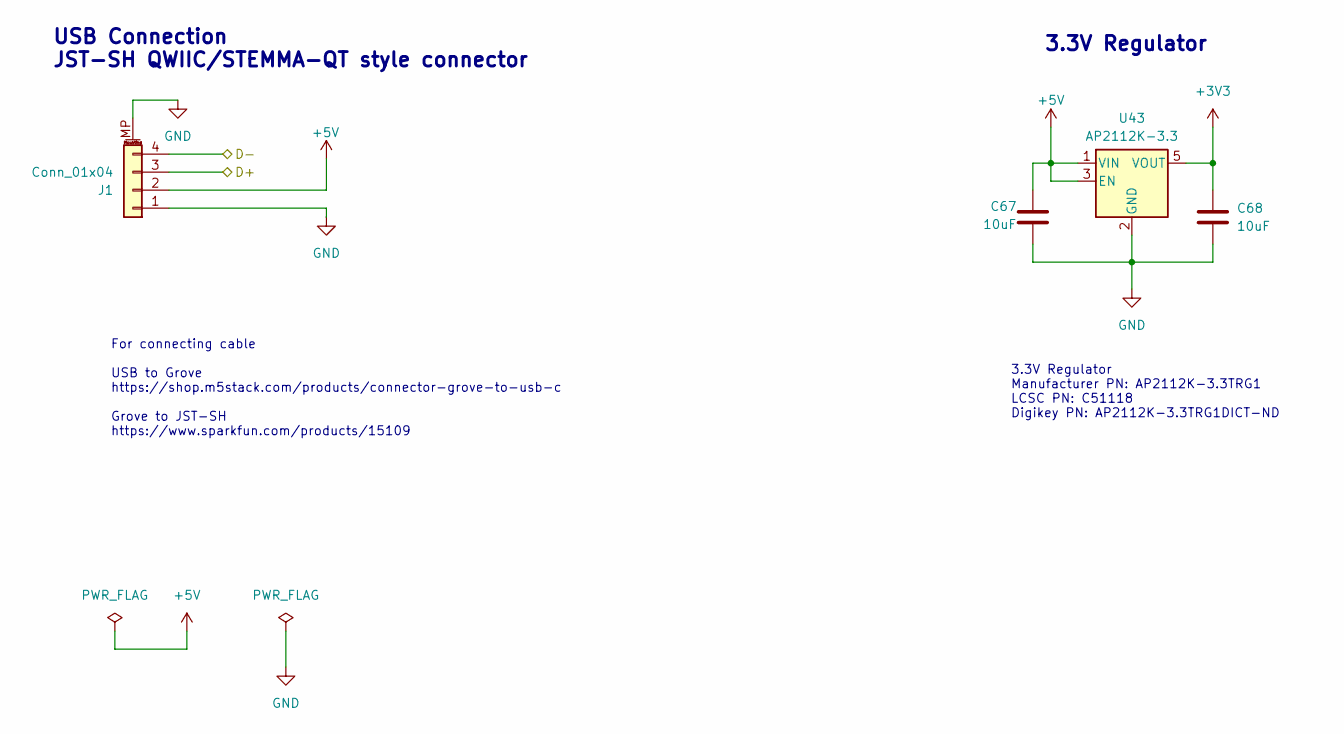
[picture p36: schematic panel_usb_power.kicad_sch, G6 PBYR 45mm RP2354]

Parts:
C67, C68: 10uF; C_0402_1005Metric; LCSC Part # C315248
J1: Conn_01x04; JST_SH_BM04B-SRSS-TB_1x04-1MP_P1.00mm_Vertical; LCSC Part # C160390
U43: AP2112K-3.3; SOT-23-5; LCSC Part # C51118

Connections:
+3V3: C68.1, U43.5 (VOUT); also elsewhere on the board
+5V: C67.1, J1.2, U43.1 (VIN), U43.3 (EN); also elsewhere on the board
/panel_mcu/D+: J1.3; also elsewhere on the board
/panel_mcu/D-: J1.4; also elsewhere on the board
GND: C67.2, C68.2, J1.1, J1.MP (MountPin), U43.2 (GND); also elsewhere on the board

Notes on the sheet:
3.3V Regulator
For connecting cable USB to Grove https://shop.m5stack.com/products/connector-grove-to-usb-c Grove to JST-SH https://www.sparkfun.com/products/15109
USB Connection JST-SH QWIIC/STEMMA-QT style connector
3.3V Regulator Manufacturer PN: AP2112K-3.3TRG1 LCSC PN: C51118 Digikey PN: AP2112K-3.3TRG1DICT-ND

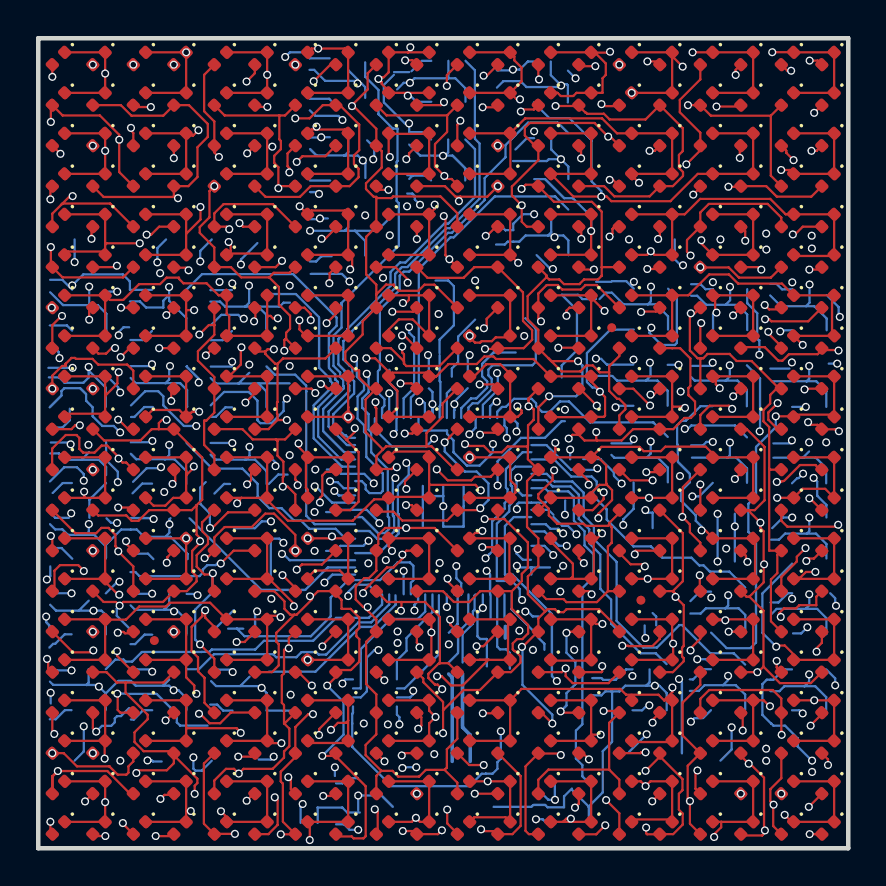
[picture p37: board panel_rp2354_20x20.kicad_pcb from above]

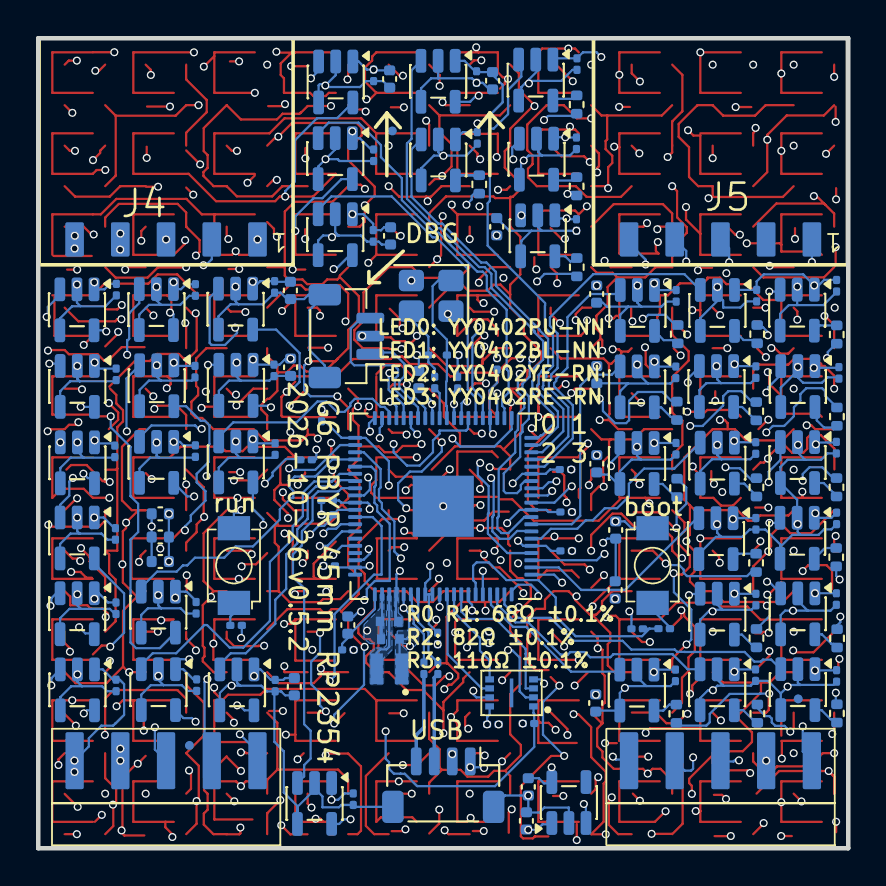
[picture p38: board panel_rp2354_20x20.kicad_pcb from below]

Board: 6 copper layers, 45.0 x 45.0 mm, 564 parts (161 on the bottom side), 134 nets.
