reiserlab/LED-Display_G6_Hardware_Panel/(commit log)

2026-09-26 IR-red panel v0.4r2: checkerboard, 33/56 Ω 0.2 W 0402 column resistors
    - LED banks: T2 -> IR (C6879329), T3 -> red (C2852592); red is now T0+T3
    (checkerboard, firmware channels 0 and 3), IR T1+T2. BOM-only change.
    - R9-R28: Resistor_SMD:R_0201_0603Metric -> R_0402_1005Metric, same
    rotation and side. Red banks 33 Ω (Panasonic ERJ-PA2F33R0X, C427231),
    IR banks 56 Ω (ERJ-PA2F56R0X, C427233; 0 stock at JLC on 2026-09-26,
    alternates listed in CHANGES-v0p4r2.md). Vishay CRCW-HP codes noted.
    - Layout: nine resistor centres nudged 0.03-0.20 mm, ten vias moved, six
    short track re-routes so every 0402 pad has >= 0.135 mm to foreign
    copper; no driver or other part moved. DRC at 0.127 mm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
    [bom.csv, designators.csv, panel_led.kicad_sch, panel_rp2354_20x20.kicad_pcb, panel_rp2354_20x20.kicad_sch, positions.csv]
2026-09-26 v0.4r2: column resistors 22 Ω red / 47 Ω IR (in-stock 0.2 W 0402 parts)
    Red banks R_T0/R_T3: Vishay CRCW040222R0FKEDHP (C313374); IR banks
    R_T1/R_T2: ROHM ESR01MZPF47R0 (C5736551). Chosen to maximise LED current
    within the 0.2 W rating using parts in stock (56 Ω had none). Model:
    red ≈87 mA at 75 % of rating, IR ≈64 mA at 88 %; all-on row current
    1.29 A, 5 V droop ≈0.65 V over the 45 µs pulse. Full-field 5 V supply
    current is ≈0.9 × row current ≈ 1.16 A per panel; the analysis doc's
    "≈50 mA" figure is wrong by ×20 — power path to be checked.
    Production BOM regenerated; positions unchanged. Notes and scripts updated.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
    [bom.csv, panel_led.kicad_sch, panel_rp2354_20x20.kicad_pcb]
2026-09-26 v0.4r2: fix all-on operating point, update silkscreen legend
    - Operating point for the chosen 22/47 Ω pair recomputed together (was
    taken from 22/56 and 33/47 columns): all-on red 79 mA / IR 57 mA, row
    1.36 A, 5 V average 1.22 A (1.29 A RMS), droop 0.68 V -> ~4.3 V at the
    drivers vs UCC27517 4.5 V min VDD. Notes updated.
    - B.SilkS legend: "R: 22|47Ω", "0|3: APHHS1005SURCK", "1|2: IN-S42CTQIR"
    (was 100Ω / 0|2 / 1|3). Gerbers and DRC report regenerated;
    schematic parity 0 issues.
    Both found by the Codex cross-review.
    [panel_rp2354_20x20.kicad_pcb]
2026-09-26 v0.4r2: conservative column resistors 47 Ω red / 100 Ω IR (~0.7 A per panel)
    Red banks R_T0/R_T3: ROHM ESR01MZPF47R0 (C5736551); IR banks R_T1/R_T2:
    Panasonic ERJ-PA2F1000X (C427235); both 0.2 W 0402. Model: red ≈52 mA
    (57 % of rating, x2 vs v0.4r1), IR ≈33 mA (50 %, unchanged); all-on row
    0.80 A, panel average ≈0.72 A, rail droop ≈0.40 V (stays above the
    UCC27517 4.5 V minimum). Replaces the 22/47 Ω variant, which drew ≈1.2 A
    per panel. Silkscreen legend "R: 47|100Ω"; production BOM, gerbers and
    DRC report regenerated (schematic parity 0).
    [bom.csv, panel_led.kicad_sch, panel_rp2354_20x20.kicad_pcb]
2026-09-26 v0.4r2: 3D renders and decisions-doc update
    - assets/: top, bottom, two isometric and a driver-cluster detail render
    of v0.4.2 with all parts placed (kicad-cli pcb render, high quality).
    - docs/Four-color and Red+IR panel decisions.md: v0.4r2 revision note
    (checkerboard mapping as ordered vs intended, 47/100 Ω 0.2 W 0402
    resistors, panel supply current) and first-article open items.
2026-10-20 improve silkscreen
2026-10-21 add DBG connector
2026-11-02 feat: four-color 20x20 panel v0.5 (violet, blue, yellow, red) (#3) (#5)
    Add the panel_rp2354_20x20_four-color_v0p5 KiCad project (revision v0.5.2): a 20x20 panel with four LED banks T0 to T3 (violet, blue, yellow, red, 100 LEDs each) on an RP2354B, with 40x UCC27517 drivers, DBG and USB-C connectors, QSPI PSRAM and custom symbol/footprint libraries.
    - Production set in production/v0p5r2/ (fabrication zip, bom.csv, designators, positions, netlist); renders and exports in assets/.
    - DRC minimum via diameter raised to 0.45 mm and minimum through-hole diameter to 0.3 mm, so undersized vias are flagged before production.
    - Ordered on 2026-10-28. Testing continues in #6.
    Fixes #3
